tuskleric/AI_Robotic_Camera/PCB/FYP_P2_1/PCB_CONN_example_FYP.png

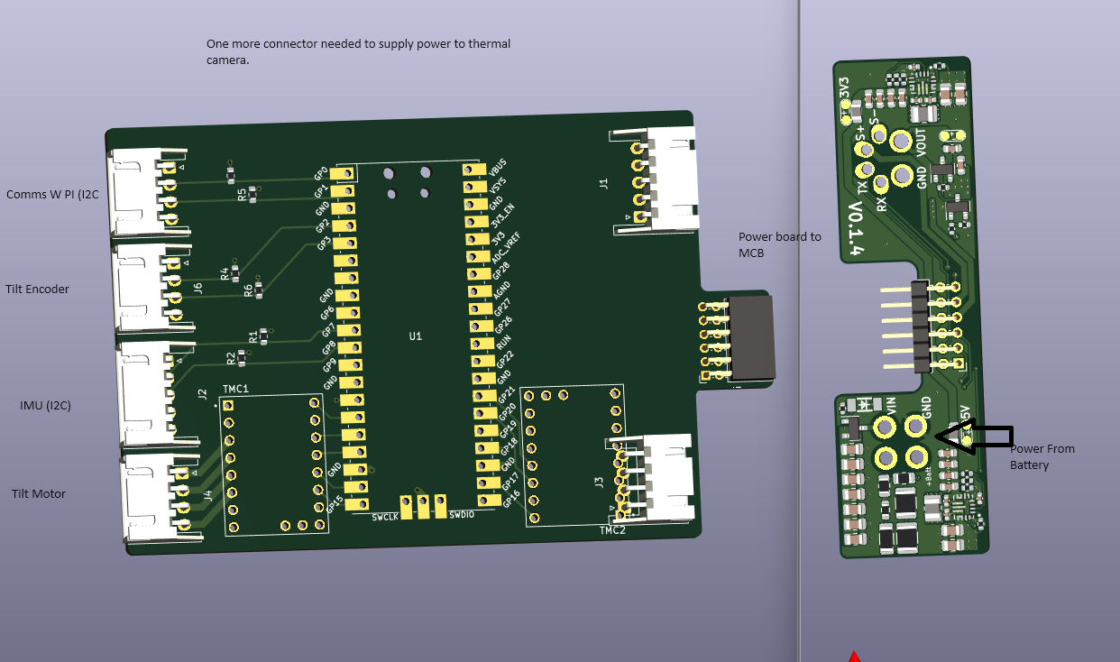
PCB/FYP_P2_1/PCB_CONN_example_FYP.png
