tuskleric/AI_Robotic_Camera/PCB/FYP_P2_2/out/FYP_P2_2_3D.png

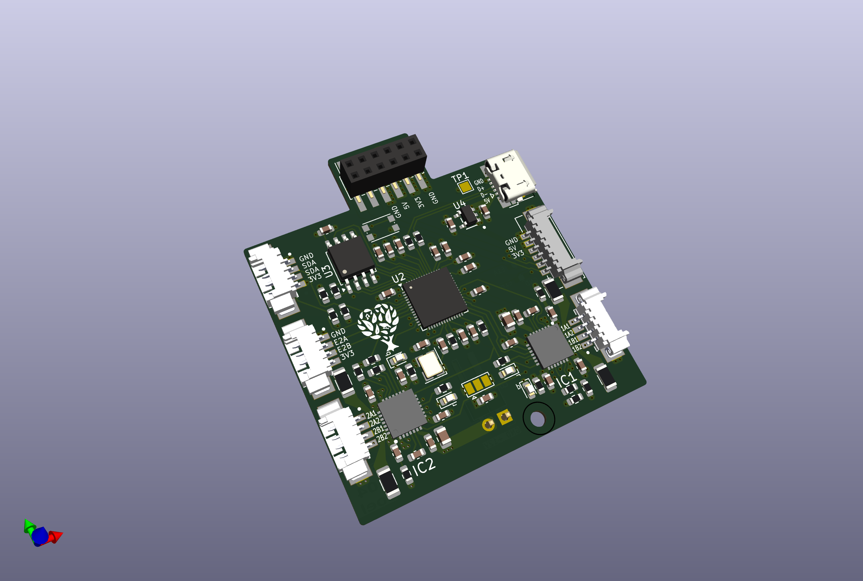
PCB/FYP_P2_2/out/FYP_P2_2_3D.png
