tuskleric/AI_Robotic_Camera/PCB/FYP_P2_2/out/FYP_P2_1.png

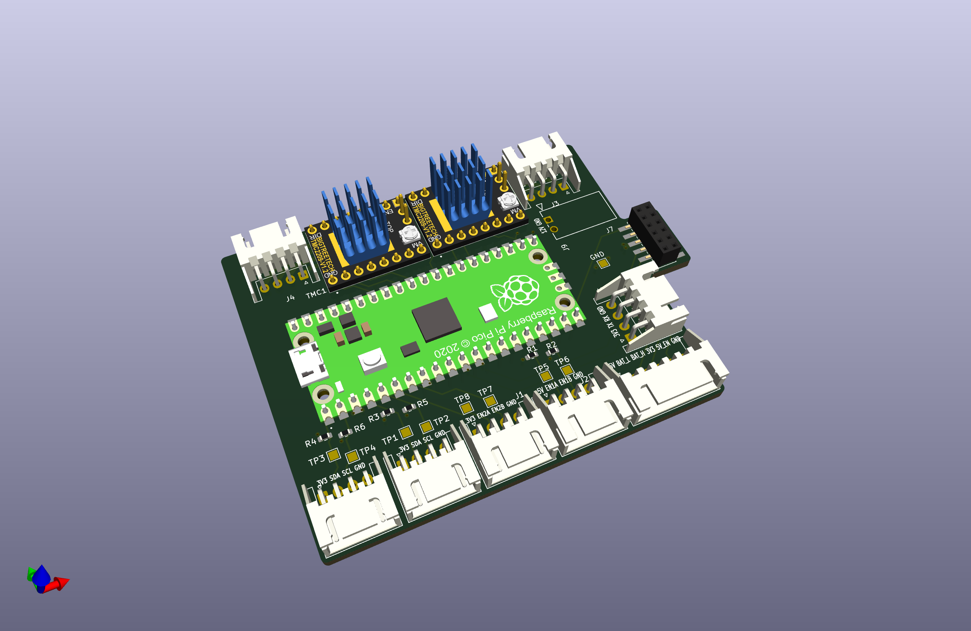
PCB/FYP_P2_2/out/FYP_P2_1.png
