tuskleric/AI_Robotic_Camera/PCB/FYP_P2_2/out/FYP_P2_2_3D_floating.png

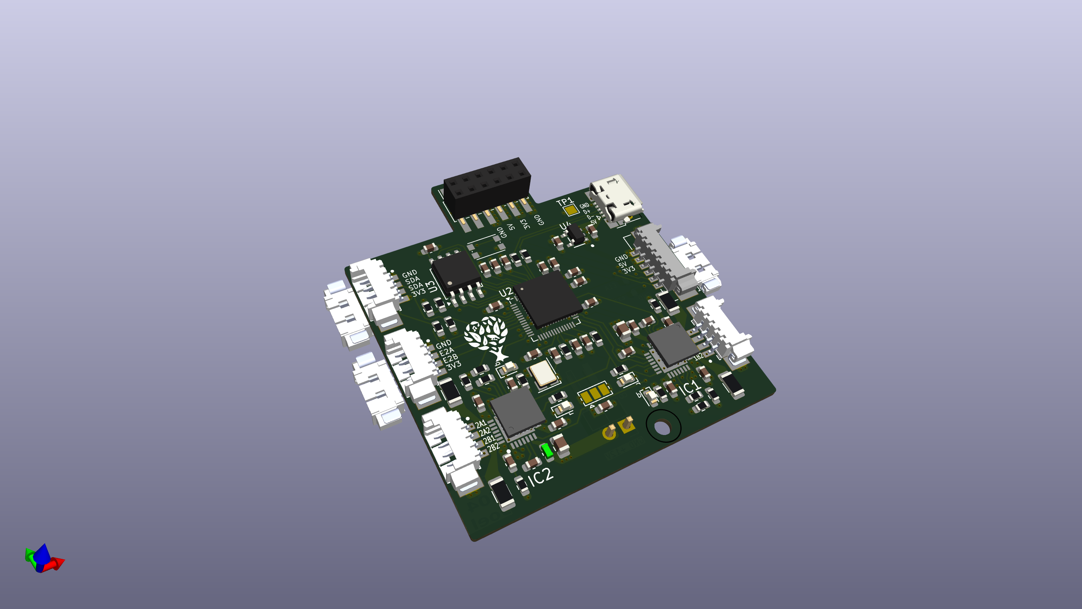
PCB/FYP_P2_2/out/FYP_P2_2_3D_floating.png
