tuskleric/AI_Robotic_Camera/PCB/FYP_P2_2/out/tc2-main-pcb.png

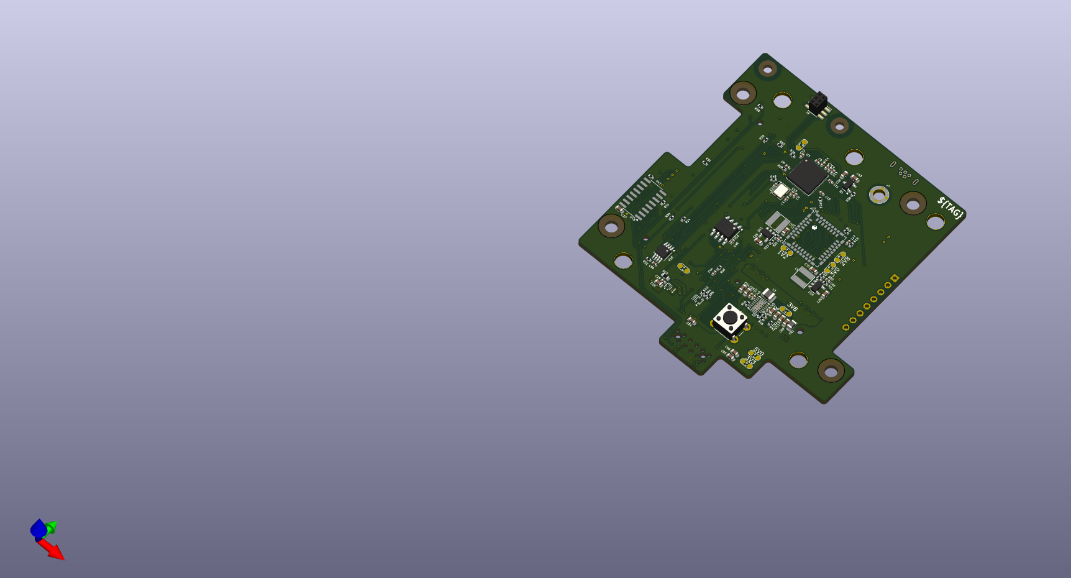
PCB/FYP_P2_2/out/tc2-main-pcb.png
