tuskleric/AI_Robotic_Camera/PCB/FYP_P2_2/out/tc2-plugs-buck-boost-pcb.png

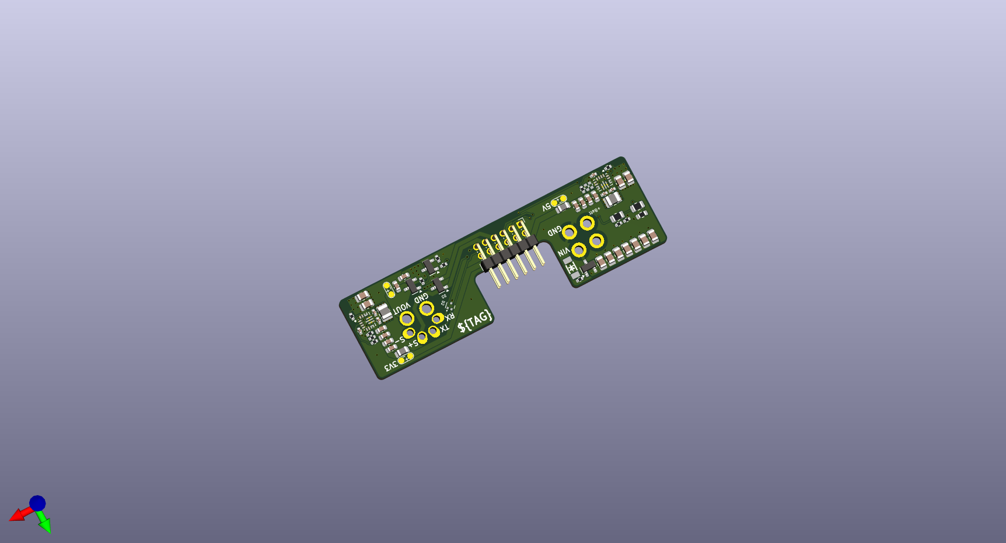
PCB/FYP_P2_2/out/tc2-plugs-buck-boost-pcb.png
