tuskleric/AI_Robotic_Camera/PCB/FYP_P2_2/out/FYP_P2_2_order_list.xlsx

Country of Origin may be different at time of shipment.
The HTSUS and ECCN information shown is for informational purposes only and is not a representation or warranty as to the accuracy or reliability of these classifications. All information is provided "as is" and is subject to change without notice. Any use made of the information provided is without recourse to Digi-Key and at the user's risk.
Index | Manufacturer Part Number | Manufacturer Name | Description | Availability | Stock Status | Attrition % | Requested Quantity 1 | Pack Quantity 1 | Pack Type 1 | Digi-Key Part Number 1 | Unit Price 1 | Extended Price 1 | Minimum Order Quantity 1 | Customer Reference | Requested Part Number | Lead Weeks | Datasheet | Reference Designator | US Import Tariff | Note | Part Status | RoHS Status | Moisture Sensitivity Level (MSL) | ECCN | HTSUS | Country of Origin | Environmental Information | Original Part numbers | Image | Product Notes
1 | 0532610471 | Molex | CONN HEADER SMD R/A 4POS 1.25MM | 68,219 | In Stock |  | 20 | 20 | Cut Tape (CT) | WM7622CT-ND | 0.61200 | $12.24 | 1 |  | WM7622CT-ND | 21 | https://www.molex.com/pdm_docs/sd/532610471_sd.pdf |  | N/A |  | Active | ROHS3 Compliant | 1 (Unlimited) | EAR99 | 8536.69.4040 | Malaysia | https://www.molex.com/datasheets/rohspdf/0532610471_rohs.pdf | WM7622CT-ND | https://mm.digikey.com/Volume0/opasdata/d220001/medias/images/1277/0532610471.jpg
2 | 0532610671 | Molex | CONN HEADER SMD R/A 6POS 1.25MM | 32,107 | In Stock |  | 5 | 5 | Cut Tape (CT) | WM7624CT-ND | 0.82000 | $4.10 | 1 |  | WM7624CT-ND | 22 | https://www.molex.com/pdm_docs/sd/532610671_sd.pdf |  | May apply on shipments to the U.S. |  | Active | ROHS3 Compliant | 1 (Unlimited) | EAR99 | 8536.69.4040 | Malaysia | https://www.molex.com/datasheets/rohspdf/0532610671_rohs.pdf | WM7624CT-ND | https://mm.digikey.com/Volume0/opasdata/d220001/medias/images/1138/53261-0671.jpg
3 | KMR211NG LFS | C&K | SWITCH TACTILE SPST-NO 0.05A 32V | 75,146 | In Stock |  | 5 | 5 | Cut Tape (CT) | CKN10243CT-ND | 0.40000 | $2.00 | 1 |  | CKN10243CT-ND | 8 | https://www.ckswitches.com/media/1479/kmr2.pdf |  | N/A |  | Active | ROHS3 Compliant | 1 (Unlimited) | EAR99 | 8536.50.9031 | France | https://www.ckswitches.com/media/3448/rohs-reach-compliance-certificate.pdf | CKN10243CT-ND | https://mm.digikey.com/Volume0/opasdata/d220001/medias/images/2588/KMR211NG%20LFS.JPG
4 | 0510210400 | Molex | CONN RCPT HSG 4POS 1.25MM | 92,947 | In Stock |  | 20 | 20 | Bag | WM1722-ND | 0.19800 | $3.96 | 1 |  | WM1722-ND | 9 | https://www.molex.com/pdm_docs/ps/PS-51021-009.pdf |  | N/A |  | Active | ROHS3 Compliant | 1 (Unlimited) | EAR99 | 8536.69.8000 | South Korea | https://www.molex.com/datasheets/rohspdf/0510210400_rohs.pdf | WM1722-ND | https://mm.digikey.com/Volume0/opasdata/d220001/medias/images/906/51021-0400.jpg
5 | 0500798000 | Molex | CONN SOCKET 26-28AWG CRIMP TIN | 444,262 | In Stock |  | 100 | 100 | Cut Tape (CT) | WM1142CT-ND | 0.04270 | $4.27 | 100 |  | WM1142CT-ND | 29 | https://www.molex.com/pdm_docs/cs/500580000-CS-000.pdf |  | N/A |  | Active | ROHS3 Compliant | 1 (Unlimited) | EAR99 | 8536.90.4000 | Malaysia | https://www.molex.com/datasheets/rohspdf/0500798000_rohs.pdf | WM1142CT-ND | https://mm.digikey.com/Volume0/opasdata/d220001/medias/images/1075/50079-8000.jpg
6 | 0510210600 | Molex | CONN RCPT HSG 6POS 1.25MM | 197,973 | In Stock |  | 5 | 5 | Bulk | WM1724-ND | 0.29000 | $1.45 | 1 |  | WM1724-ND | 8 | https://www.molex.com/pdm_docs/ps/PS-51021-009.pdf |  | N/A |  | Active | ROHS3 Compliant | 1 (Unlimited) | EAR99 | 8536.69.8000 | South Korea | https://www.molex.com/datasheets/rohspdf/0510210600_rohs.pdf | WM1724-ND | https://mm.digikey.com/Volume0/opasdata/d220001/medias/images/986/51021-0600.jpg
7 | GMC10X7R105K50NT | Cal-Chip Electronics, Inc. | CAP0603 X7R 1UF 10% 50V | 3,543 | In Stock |  | 10 | 10 | Cut Tape (CT) | 4713-GMC10X7R105K50NTCT-ND | 0.14400 | $1.44 | 1 |  | 4713-GMC10X7R105K50NTCT-ND | 8 | https://calchip.com/wp-content/uploads/2023/09/GMC-Series-2.pdf |  | N/A |  | Active | ROHS3 Compliant | 1 (Unlimited) | EAR99 | 8532.24.0020 | South Korea | https://88c.e57.myftpupload.com/wp-content/uploads/2022/06/Certificate-of-Compliance.pdf | 4713-GMC10X7R105K50NTCT-ND | https://mm.digikey.com/Volume0/opasdata/d220001/medias/images/4904/MFG_GMC43X5R226K10NT.jpg | Non Cancellable Non Returnable.
8 | KGM15CR51E226MT | KYOCERA AVX | 0603 X5R 22UF20% 25V | 0 | Normally Stocking |  | 5 | 5 | Cut Tape (CT) | 478-KGM15CR51E226MTCT-ND | 0.42000 | $2.10 | 1 |  | 478-KGM15CR51E226MTCT-ND | 16 | https://datasheets.kyocera-avx.com/cx5r-KGM.pdf |  | N/A |  | Active | ROHS3 Compliant | 1 (Unlimited) | EAR99 | 8532.24.0020 | Japan |  | 478-KGM15CR51E226MTCT-ND | https://mm.digikey.com/Volume0/opasdata/d220001/medias/images/6295/MFG_KGMSERIES.jpg
9 | GRM21BR61H106KE43K | Murata Electronics | CAP CER 10UF 50V X5R 0805 | 3 | In Stock |  | 10 | 10 | Cut Tape (CT) | 490-GRM21BR61H106KE43KCT-ND | 0.19100 | $1.91 | 1 |  | 490-GRM21BR61H106KE43KCT-ND | 19 | https://search.murata.co.jp/Ceramy/image/img/A01X/G101/ENG/GRM21BR61H106KE43-01A.pdf |  | N/A |  | Active | ROHS3 Compliant | 1 (Unlimited) | EAR99 | 8532.24.0020 | Japan |  | 490-GRM21BR61H106KE43KCT-ND | https://mm.digikey.com/Volume0/opasdata/d220001/medias/images/5447/490-Ceramic-Capacitor-Tan-Field.jpg
10 | TMC2209-LA | Analog Devices Inc./Maxim Integrated | IC MTR DRV 4.75-28V QFN28 | 421 | In Stock |  | 6 | 6 | Tray | 505-TMC2209-LA-ND | 2.47000 | $14.82 | 1 |  | 505-TMC2209-LA-ND | 18 | https://www.analog.com/media/en/technical-documentation/data-sheets/TMC2209_datasheet_rev1.09.pdf |  | N/A |  | Active | ROHS3 Compliant | 3 (168 Hours) | EAR99 | 8542.39.0060 | Taiwan | https://www.trinamic.com/fileadmin/assets/Company/Quality/TMC_IC_ROHS_3v6.pdf | 505-TMC2209-LA-ND
11 | SC0914(13) | Raspberry Pi | IC MCU 32BIT EXT MEM 56QFN | 47,248 | In Stock |  | 5 | 5 | Cut Tape (CT) | 2648-SC0914(13)CT-ND | 0.70000 | $3.50 | 1 |  | 2648-SC0914(13)CT-ND | 8 | https://datasheets.raspberrypi.com/rp2040/rp2040-datasheet.pdf |  | N/A |  | Active | ROHS3 Compliant | 1 (Unlimited) | 3A991A2 | 8542.31.0025 | Taiwan | https://pip.raspberrypi.com/categories/601-documents-covering-all-products | 2648-SC0914(13)CT-ND | https://mm.digikey.com/Volume0/opasdata/d220001/medias/images/4303/MFG_RP2040.jpg
12 | W25Q128JVSIQ | Winbond Electronics | IC FLASH 128MBIT SPI/QUAD 8SOIC | 91,047 | In Stock |  | 5 | 5 | Tube | W25Q128JVSIQ-ND | 1.73000 | $8.65 | 1 |  | W25Q128JVSIQ-ND | 12 | https://www.winbond.com/resource-files/W25Q128JV%20RevI%2008232021%20Plus.pdf |  | N/A |  | Active | ROHS3 Compliant | 3 (168 Hours) | 3A991B1A | 8542.32.0071 | Taiwan | https://www.winbond.com/hq/support/documentation/?pageIndex=1&__locale=en | W25Q128JVSIQ-ND | https://mm.digikey.com/Volume0/opasdata/d220001/medias/images/371/8-SOIC_751.jpg
13 | ABM8-272-T3 | Abracon LLC | CRYSTAL 12.0000MHZ 10PF SMD | 8,033 | In Stock |  | 5 | 5 | Cut Tape (CT) | 535-ABM8-272-T3CT-ND | 0.58000 | $2.90 | 1 |  | 535-ABM8-272-T3CT-ND | 15 | https://mm.digikey.com/Volume0/opasdata/d220001/medias/docus/6128/ABM8-272-T3.pdf |  | May apply on shipments to the U.S. |  | Active | ROHS3 Compliant | Not Applicable | EAR99 | 8541.60.0050 | China |  | 535-ABM8-272-T3CT-ND | https://mm.digikey.com/Volume0/opasdata/d220001/medias/images/4464/MFG_ABM8.jpg | No Backorders Allowed.
14 | BF100-12-A-D-1-0640-L-C | GCT | 12POS, 2MM PITCH SOCKET, DIL, SM | 2,367 | In Stock |  | 10 | 10 | Cut Tape (CT) | 2073-BF100-12-A-D-1-0640-L-CCT-ND | 0.46800 | $4.68 | 1 |  | 2073-BF100-12-A-D-1-0640-L-CCT-ND | 9 | https://gct.co/files/drawings/bf100.pdf |  | May apply on shipments to the U.S. |  | Active | ROHS3 Compliant | 1 (Unlimited) | EAR99 | 8536.69.4040 | China | https://gct.co/files/info/gct_certificate_of_compliance.pdf | 2073-BF100-12-A-D-1-0640-L-CCT-ND | https://mm.digikey.com/Volume0/opasdata/d220001/medias/images/4280/MFG_BF100-12-A-x-x-06xx-x-x.jpg
15 | 2N7002NXAKR | Nexperia USA Inc. | MOSFET N-CH 60V 190MA TO236AB | 69,351 | In Stock |  | 10 | 10 | Cut Tape (CT) | 1727-8643-1-ND | 0.10500 | $1.05 | 1 |  | 1727-8643-1-ND | 6 | https://assets.nexperia.com/documents/data-sheet/2N7002NXAK.pdf |  | N/A |  | Active | ROHS3 Compliant | 1 (Unlimited) | EAR99 | 8541.29.0095 | Malaysia |  | 1727-8643-1-ND | https://mm.digikey.com/Volume0/opasdata/d220001/medias/images/5527/1727%7ESOT23-3%7ES23%7E3.jpg
16 | CRL1206-FW-R150ELF | Bourns Inc. | RES 0.15 OHM 1% 1/2W 1206 | 24,764 | In Stock |  | 10 | 10 | Cut Tape (CT) | 118-CRL1206-FW-R150ELFCT-ND | 0.10800 | $1.08 | 1 |  | 118-CRL1206-FW-R150ELFCT-ND | 14 | https://www.bourns.com/docs/Product-Datasheets/CRL.pdf |  | N/A |  | Active | ROHS3 Compliant | 1 (Unlimited) | EAR99 | 8533.21.0030 | Taiwan | https://www.bourns.com/docs/Product-MDS/crl1206_mds.pdf|https://www.bourns.com/docs/rohs-content/bourns-reach-letter.pdf|https://www.bourns.com/docs/rohs-cofc/crx_coc2.pdf?sfvrsn=da0774f6_12 | 118-CRL1206-FW-R150ELFCT-ND | https://mm.digikey.com/Volume0/opasdata/d220001/medias/images/2376/CRL%20Series%201206%20%283216%20Metric%29.jpg
