tuskleric/AI_Robotic_Camera/FYP_P2/BOM.xlsx

12 MHz crystal | 406C35D12M00000 | 406C35D12M00000 CTS-Frequency Controls | Crystals, Oscillators, Resonators | DigiKey (https://www.digikey.co.nz/en/products/detail/406C35D12M00000/CTX855CT-ND/2293035?curr=usd)
Flash memory | W25Q128JVS | https://www.digikey.co.nz/en/products/detail/winbond-electronics/W25Q128JVSIQ/5803943
