tuskleric/AI_Robotic_Camera/components_models/B4B-PH-SM4-TB/B4B-PH-SM4-TB.STEP

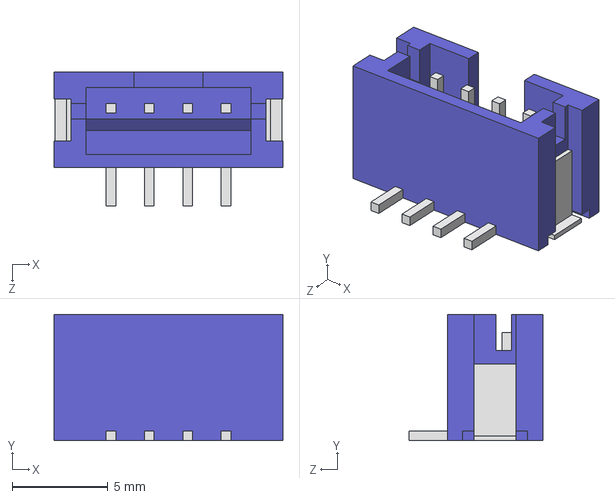
[picture p7: CAD file, 2024-05-13]
components_models/B4B-PH-SM4-TB/B4B-PH-SM4-TB.STEP
12.0 x 6.60 x 7.00 mm
