tuskleric/AI_Robotic_Camera/components_models/B5B-PH-SM4-TB/B5B-PH-SM4-TB.STEP

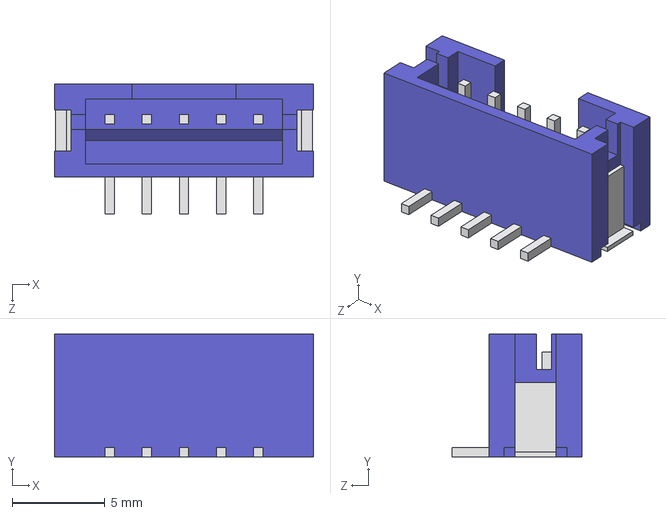
[picture p8: CAD file, 2024-05-13]
components_models/B5B-PH-SM4-TB/B5B-PH-SM4-TB.STEP
14.0 x 6.60 x 7.00 mm
