tuskleric/AI_Robotic_Camera/components_models/BOARD-BOARD/06JQ-ST/06JQ-ST.STEP

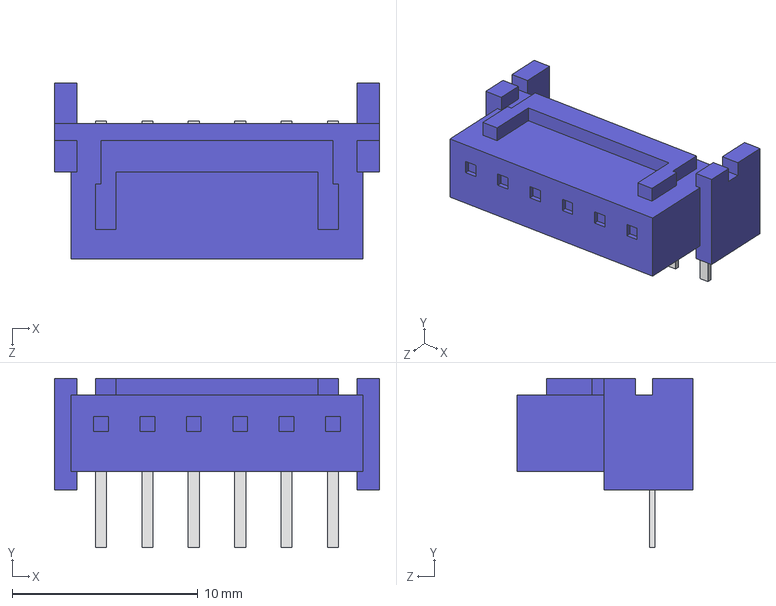
[picture p9: CAD file, 2024-05-13]
components_models/BOARD-BOARD/06JQ-ST/06JQ-ST.STEP
17.5 x 9.10 x 9.50 mm
