tuskleric/AI_Robotic_Camera/components_models/BOARD-BOARD/S5B-XH-A-1/S5B-XH-A-1.STEP

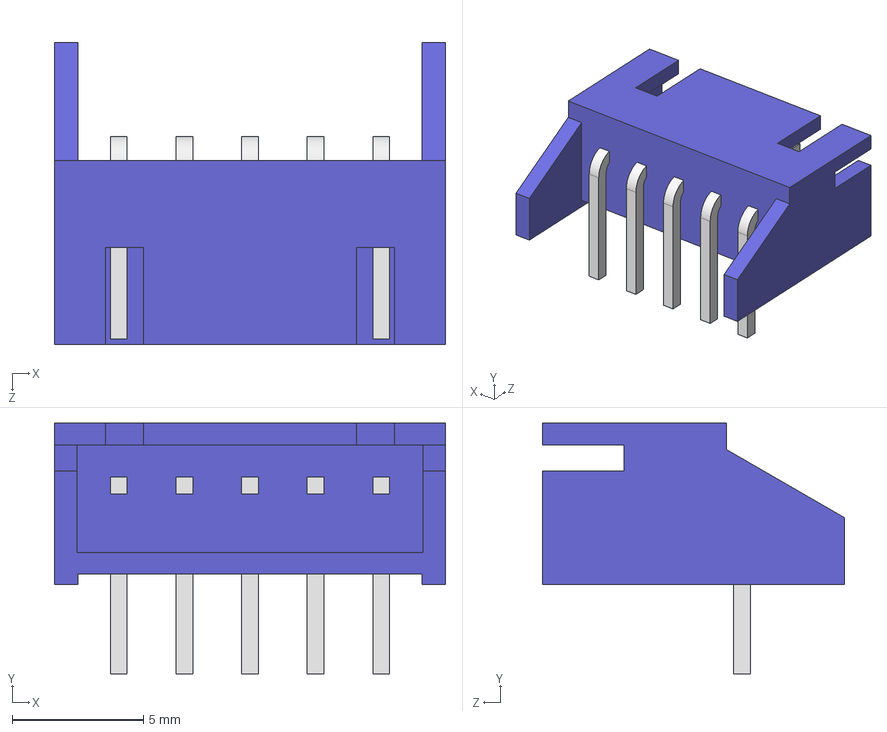
[picture p10: CAD file, 2024-05-13]
components_models/BOARD-BOARD/S5B-XH-A-1/S5B-XH-A-1.STEP
14.9 x 9.55 x 11.5 mm
