tuskleric/AI_Robotic_Camera/PCB/FYP_P2_1/raspberry pi pico with contacts.step

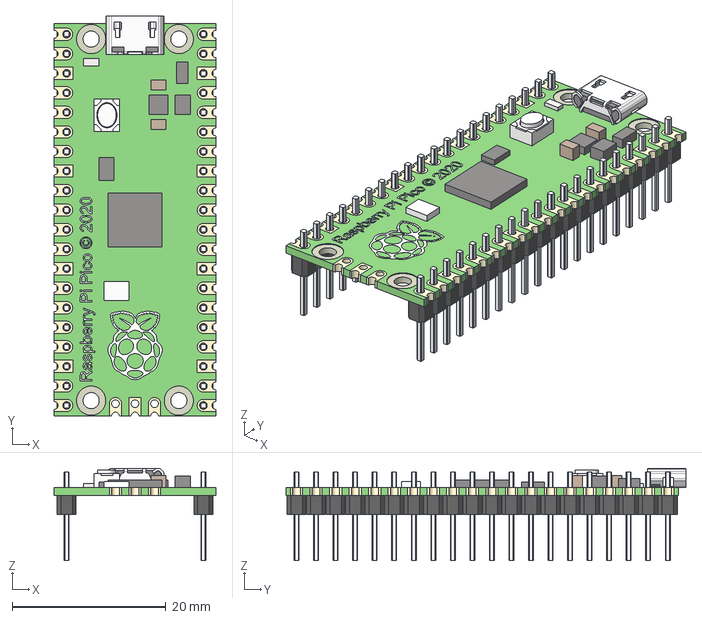
[picture p11: CAD file, 2024-10-09]
PCB/FYP_P2_1/raspberry pi pico with contacts.step
21.0 x 52.0 x 12.0 mm
ножка x 20
ножка v3(Mirror) x 20
