tuskleric/AI_Robotic_Camera/PCB/FYP_P2_2/components/LIB_TMC2209-LA/TMC2209-LA/3D/TMC2209-LA.stp

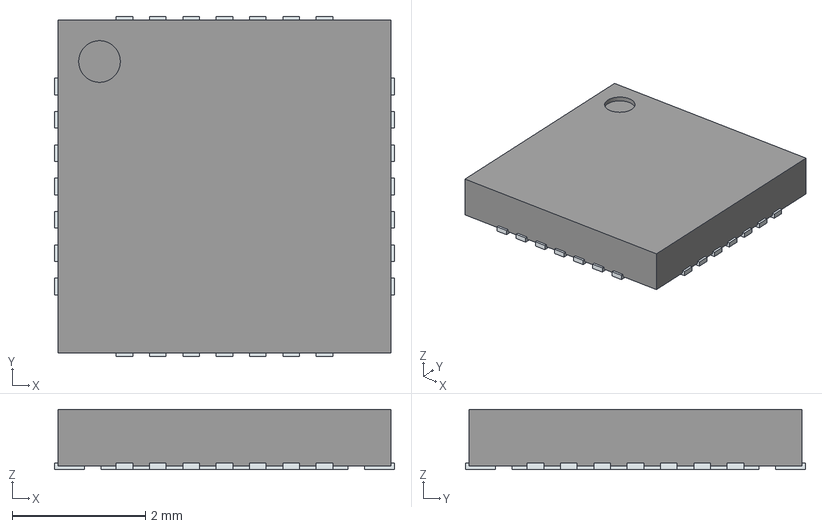
[picture p12: CAD file, 2024-10-09]
PCB/FYP_P2_2/components/LIB_TMC2209-LA/TMC2209-LA/3D/TMC2209-LA.stp
5.10 x 5.10 x 0.9 mm
ThermalPin
PinsArrayLR
PinsArrayTB
