tuskleric/AI_Robotic_Camera/PCB/FYP_P2_1/BTT TMC2209-V1.2.STEP

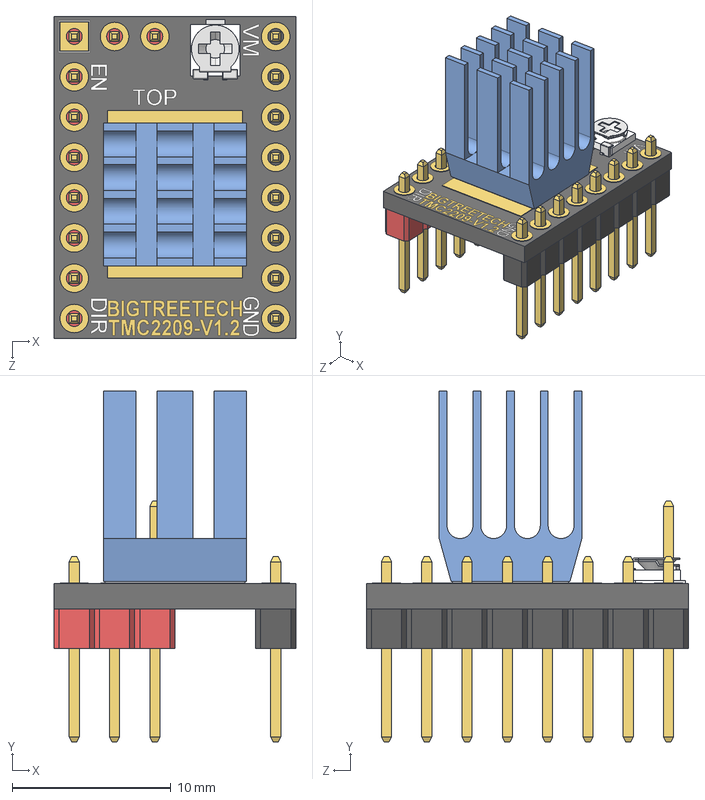
[picture p13: CAD file, 2024-10-09]
PCB/FYP_P2_1/BTT TMC2209-V1.2.STEP
15.2 x 22.1 x 20.3 mm
TMC2209_board
Pin_Header_1x2_red
Pin_Header_1x8_red
Pin_Header_1x8_black
EVM-3E___ _________
TMC2209_heatsink
