tuskleric/AI_Robotic_Camera/PCB/FYP_P2_1/pcb_19_07.step

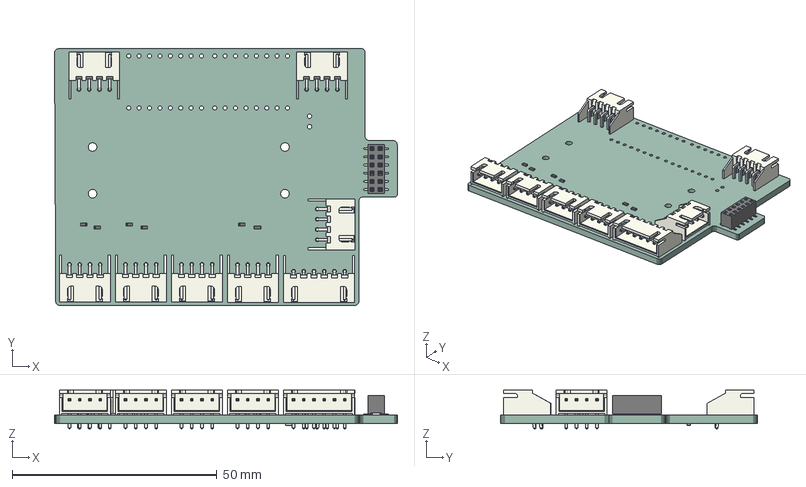
[picture p14: CAD file, 2024-10-09]
PCB/FYP_P2_1/pcb_19_07.step
83.8 x 62.8 x 9.50 mm
JST_S4B_XH_A x 7
R_0603_1608Metric x 7
PinSocket_2x06_P200mm_Vertical_SMD
JST_S6B_XH_A_1
FYP_P2_1 PCB
