tuskleric/AI_Robotic_Camera/PCB/FYP_P2_1/FYP_P2_1.step

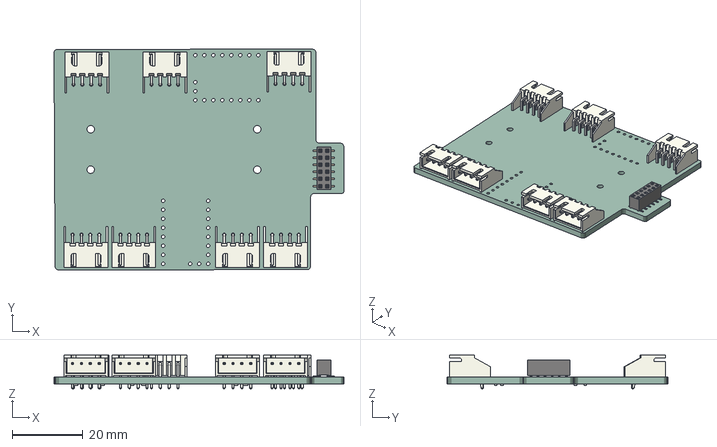
[picture p15: CAD file, 2024-10-09]
PCB/FYP_P2_1/FYP_P2_1.step
81.8 x 62.2 x 9.50 mm
PCB
