tuskleric/AI_Robotic_Camera/PCB/components_models/molex connector/1719740002(1)/1719740002.step

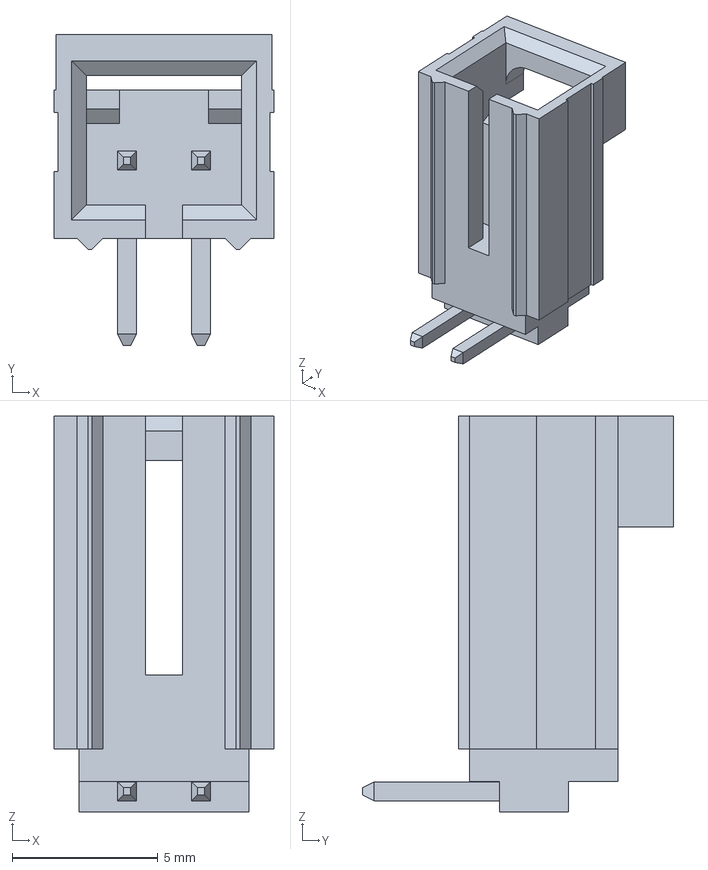
[picture p16: CAD file, 2024-10-09]
PCB/components_models/molex connector/1719740002(1)/1719740002.step
7.54 x 10.7 x 13.6 mm
