tuskleric/AI_Robotic_Camera/PCB/FYP_P2_2/components/0532610471/0532610471.step

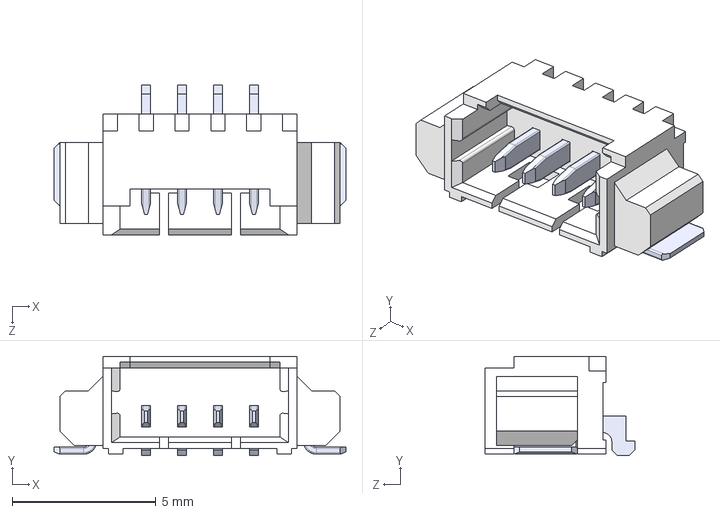
[picture p17: CAD file, 2024-10-09]
PCB/FYP_P2_2/components/0532610471/0532610471.step
10.2 x 3.45 x 5.20 mm
