tuskleric/AI_Robotic_Camera/PCB/FYP_P2_2/components/0532610671/532610671.step

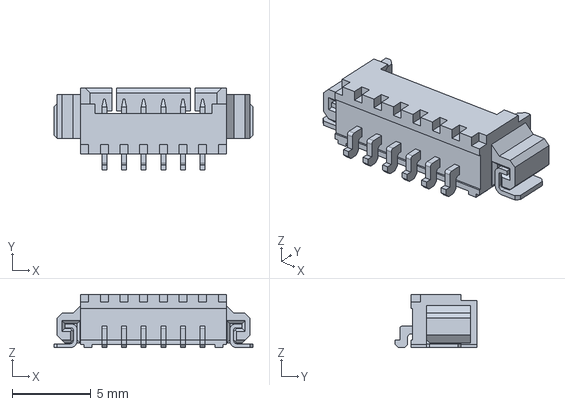
[picture p18: CAD file, 2024-10-09]
PCB/FYP_P2_2/components/0532610671/532610671.step
12.7 x 5.20 x 3.40 mm
