tuskleric/AI_Robotic_Camera/(list of files, cad)

Other CAD files:
PCB/FYP_P2_2/tc2-main.pcb.FCStd
PCB/FYP_P2_1/pcb_19_07.SLDPRT
PCB/FYP_P2_2/components/LIB_TMC2209-LA/TMC2209-LA/Allegro/qfn50p500x500x90-29n.psm
PCB/FYP_P2_2/components/LIB_TMC2209-LA/TMC2209-LA/DEHDL/tmc2209_la/chips/chips.prt
PCB/components_models/LIB_PICO/PICO/Allegro/pico.psm
PCB/components_models/LIB_PICO/PICO/DEHDL/pico/chips/chips.prt
