tuskleric/AI_Robotic_Camera/PCB/FYP_P2_2/out/F.pdf

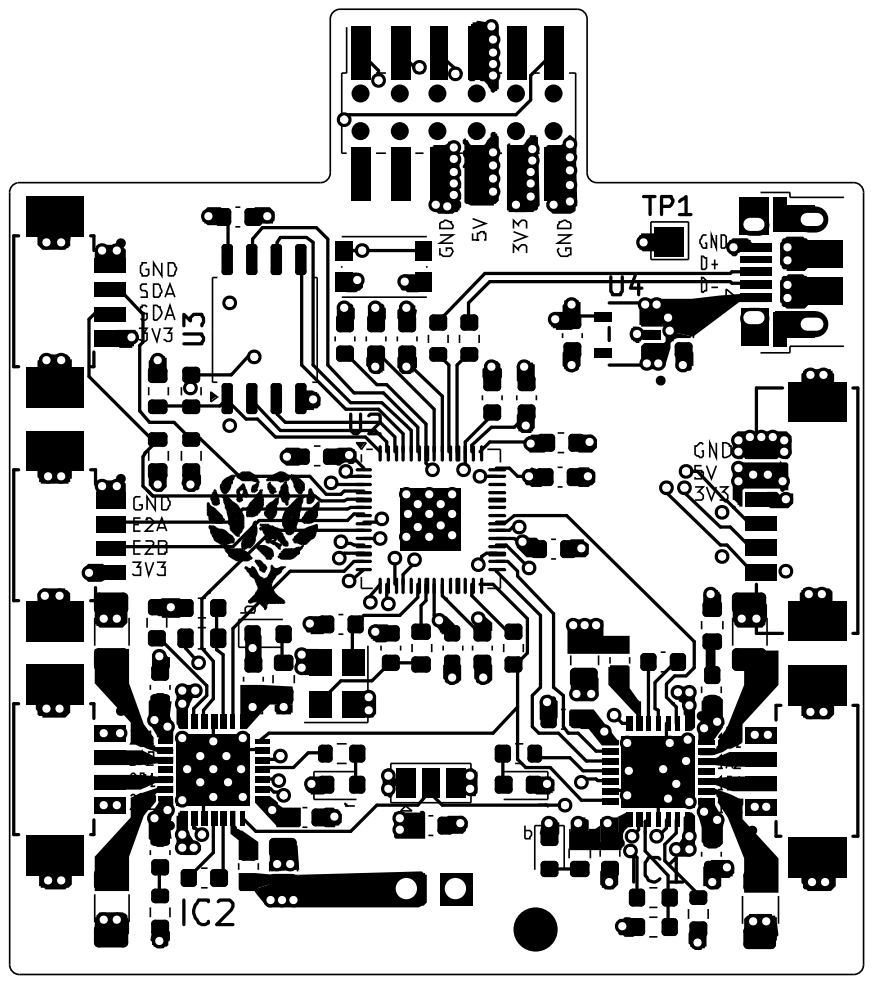
[picture p19: page 1]
