tuskleric/AI_Robotic_Camera/(list of files, drawings)

Other design files:
PCB/FYP_P2_2/components/LIB_TMC2209-LA/TMC2209-LA/Altium/QFN50P500X500X90-29N.PcbLib
PCB/FYP_P2_2/components/LIB_TMC2209-LA/TMC2209-LA/Altium/TMC2209-LA.SchLib
