tuskleric/AI_Robotic_Camera/PCB/FYP_P2_2/FYP_P2_2.kicad_pcb

## KiCad design PCB/FYP_P2_2/FYP_P2_2.kicad_pcb (2024-10-09)

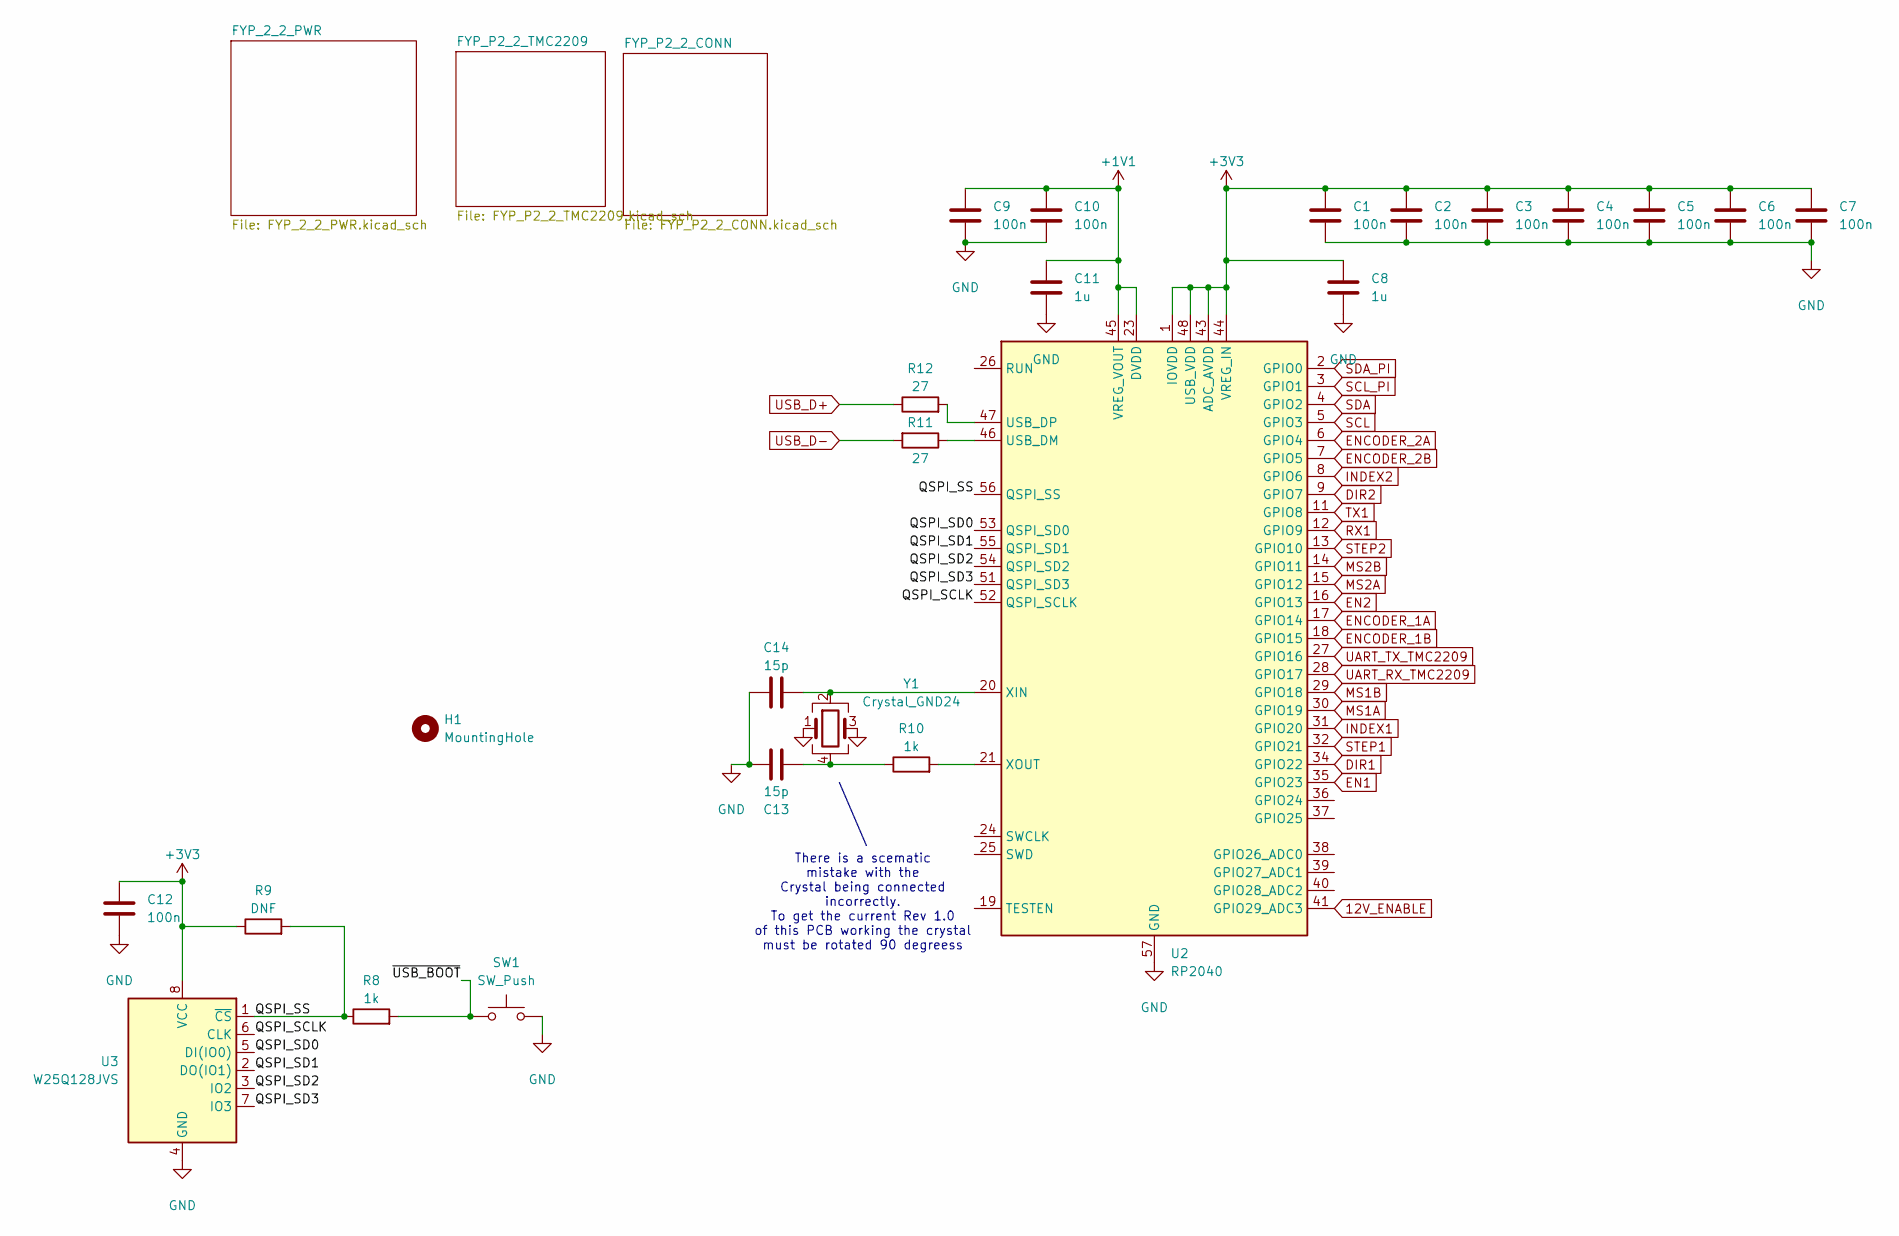
[picture p20: schematic FYP_P2_2.kicad_sch]

Parts:
C1, C2, C3, C4, C5, C6, C7, C9, C10, C12: 100n; C_0603_1608Metric
C8, C11: 1u; C_0603_1608Metric
C13, C14: 15p; C_0603_1608Metric
H1: MountingHole; MountingHole_2.2mm_M2
R8, R10: 1k; R_0603_1608Metric
R9: DNF; R_0603_1608Metric
R11, R12: 27; R_0603_1608Metric
SW1: SW_Push; SW_Push_1P1T_NO_CK_KMR2
U2: RP2040; QFN-56-1EP_7x7mm_P0.4mm_EP3.2x3.2mm
U3: W25Q128JVS; SOIC-8_5.23x5.23mm_P1.27mm
Y1: Crystal_GND24; Crystal_SMD_3225-4Pin_3.2x2.5mm

Connections:
12V_ENABLE: U2.41 (GPIO29_ADC3); also elsewhere on the board
+1V1: C9.1, C10.1, C11.1, U2.23 (DVDD), U2.45 (VREG_VOUT), U2.50 (DVDD)
+3V3: C1.1, C2.1, C3.1, C4.1, C5.1, C6.1, C7.1, C8.1, C12.1, R9.1, U2.1 (IOVDD), U2.10 (IOVDD), U2.22 (IOVDD), U2.33 (IOVDD), U2.42 (IOVDD), U2.43 (ADC_AVDD), U2.44 (VREG_IN), U2.48 (USB_VDD), U2.49 (IOVDD), U3.8 (VCC); also elsewhere on the board
/QSPI_SCLK: U2.52 (QSPI_SCLK), U3.6 (CLK)
/QSPI_SD0: U2.53 (QSPI_SD0), U3.5 (DI(IO0))
/QSPI_SD1: U2.55 (QSPI_SD1), U3.2 (DO(IO1))
/QSPI_SD2: U2.54 (QSPI_SD2), U3.3 (IO2)
/QSPI_SD3: U2.51 (QSPI_SD3), U3.7 (IO3)
/QSPI_SS: R8.1, R9.2, U2.56 (QSPI_SS), U3.1 (~CS)
/~USB_BOOT: R8.2, SW1.1
DIR1: U2.34 (GPIO22); also elsewhere on the board
DIR2: U2.9 (GPIO7); also elsewhere on the board
EN1: U2.35 (GPIO23); also elsewhere on the board
EN2: U2.16 (GPIO13); also elsewhere on the board
ENCODER_1A: U2.17 (GPIO14); also elsewhere on the board
ENCODER_1B: U2.18 (GPIO15); also elsewhere on the board
ENCODER_2A: U2.6 (GPIO4); also elsewhere on the board
ENCODER_2B: U2.7 (GPIO5); also elsewhere on the board
GND: C1.2, C2.2, C3.2, C4.2, C5.2, C6.2, C7.2, C8.2, C9.2, C10.2, C11.2, C12.2, C13.1, C14.2, SW1.2, U2.57 (GND), U3.4 (GND), Y1.1, Y1.3; also elsewhere on the board
INDEX1: U2.31 (GPIO20); also elsewhere on the board
INDEX2: U2.8 (GPIO6); also elsewhere on the board
MS1A: U2.30 (GPIO19); also elsewhere on the board
MS1B: U2.29 (GPIO18); also elsewhere on the board
MS2A: U2.15 (GPIO12); also elsewhere on the board
MS2B: U2.14 (GPIO11); also elsewhere on the board
unnamed: C13.2, R10.1, Y1.4
unnamed: R11.1, U2.46 (USB_DM)
unnamed: R12.2, U2.47 (USB_DP)
unnamed: C14.1, U2.20 (XIN), Y1.2
unnamed: R10.2, U2.21 (XOUT)
RX1: U2.12 (GPIO9); also elsewhere on the board
SCL: U2.5 (GPIO3); also elsewhere on the board
SCL_PI: U2.3 (GPIO1); also elsewhere on the board
SDA: U2.4 (GPIO2); also elsewhere on the board
SDA_PI: U2.2 (GPIO0); also elsewhere on the board
STEP1: U2.32 (GPIO21); also elsewhere on the board
STEP2: U2.13 (GPIO10); also elsewhere on the board
TX1: U2.11 (GPIO8); also elsewhere on the board
UART_RX_TMC2209: U2.28 (GPIO17); also elsewhere on the board
UART_TX_TMC2209: U2.27 (GPIO16); also elsewhere on the board
USB_D+: R12.1; also elsewhere on the board
USB_D-: R11.2; also elsewhere on the board

Notes on the sheet:
There is a scematic mistake with the Crystal being connected incorrectly. To get the current Rev 1.0 of this PCB working the crystal must be rotated 90 degreess

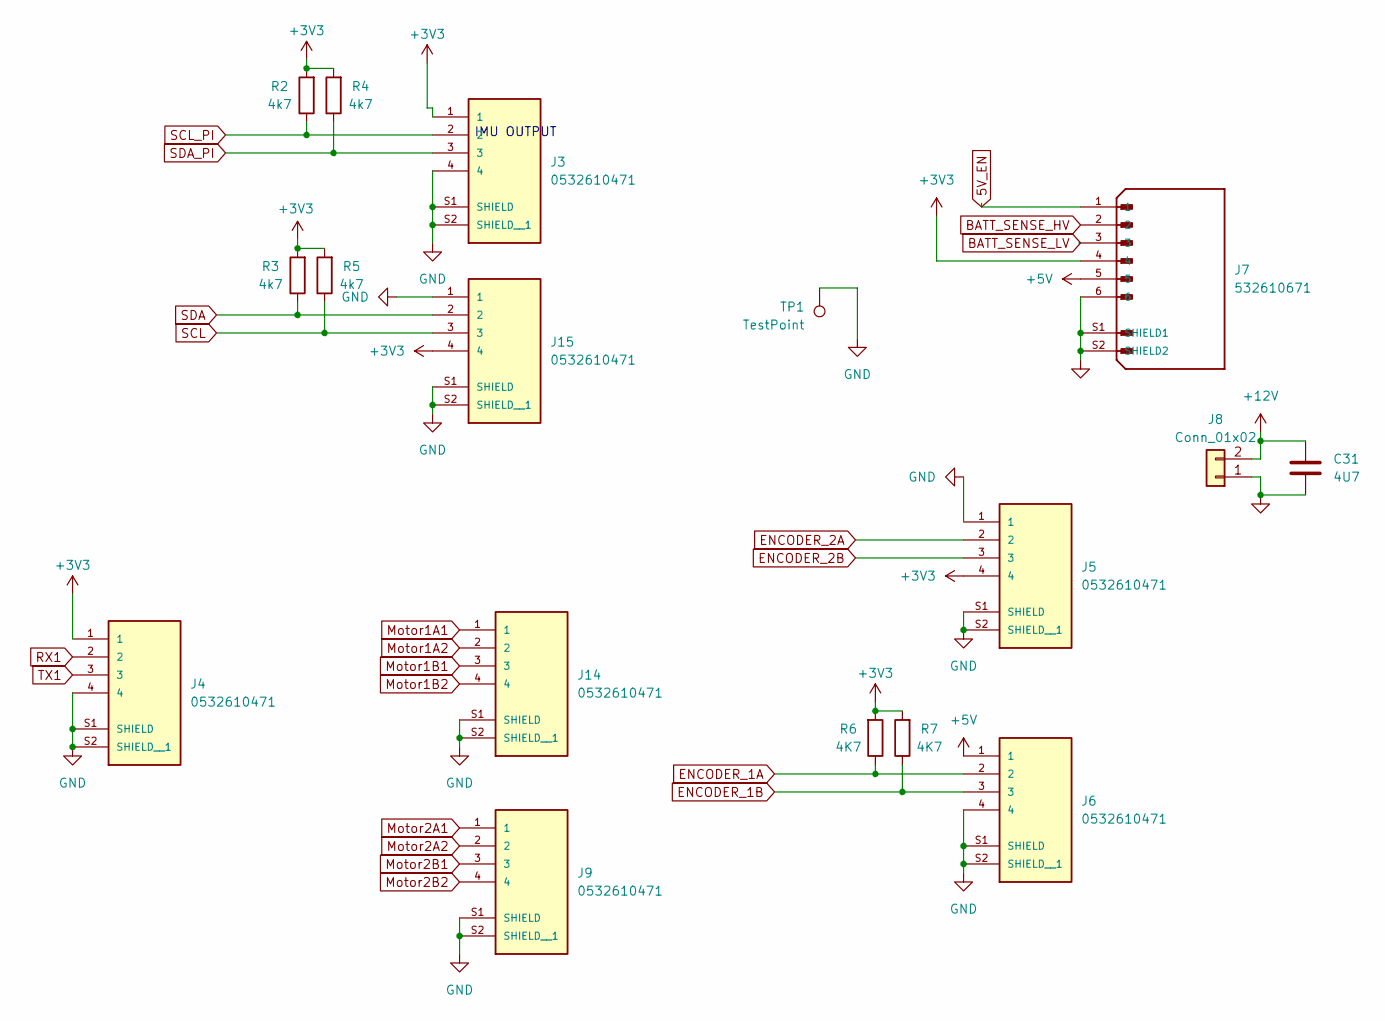
[picture p21: schematic FYP_P2_2_CONN.kicad_sch]

Parts:
C31: 4U7; C_0603_1608Metric
J3, J4, J5, J6, J9, J14, J15: 0532610471; MOLEX_0532610471; PARTREV J
J7: 532610671; MOLEX_532610671; PARTREV J
J8: Conn_01x02; PinHeader_1x02_P2.54mm_Horizontal
R2, R3, R4, R5: 4k7; R_0603_1608Metric
R6, R7: 4K7; R_0603_1608Metric
TP1: TestPoint; TestPoint_Pad_1.5x1.5mm

Connections:
5V_EN: J7.1; also elsewhere on the board
+3V3: J3.1, J4.1, J5.4, J7.4, J15.4, R2.2, R3.2, R4.2, R5.2, R6.2, R7.2; also elsewhere on the board
+5V: J6.1, J7.5; also elsewhere on the board
+12V: C31.1, J8.2; also elsewhere on the board
BATT_SENSE_HV: J7.2; also elsewhere on the board
BATT_SENSE_LV: J7.3; also elsewhere on the board
ENCODER_1A: J6.2, R6.1; also elsewhere on the board
ENCODER_1B: J6.3, R7.1; also elsewhere on the board
ENCODER_2A: J5.2; also elsewhere on the board
ENCODER_2B: J5.3; also elsewhere on the board
GND: C31.2, J3.4, J3.S1 (SHIELD), J3.S2 (SHIELD__1), J4.4, J4.S1 (SHIELD), J4.S2 (SHIELD__1), J5.1, J5.S1 (SHIELD), J5.S2 (SHIELD__1), J6.4, J6.S1 (SHIELD), J6.S2 (SHIELD__1), J7.6, J7.S1 (SHIELD1), J7.S2 (SHIELD2), J8.1, J9.S1 (SHIELD), J9.S2 (SHIELD__1), J14.S1 (SHIELD), J14.S2 (SHIELD__1), J15.1, J15.S1 (SHIELD), J15.S2 (SHIELD__1), TP1.1; also elsewhere on the board
Motor1A1: J14.1; also elsewhere on the board
Motor1A2: J14.2; also elsewhere on the board
Motor1B1: J14.3; also elsewhere on the board
Motor1B2: J14.4; also elsewhere on the board
Motor2A1: J9.1; also elsewhere on the board
Motor2A2: J9.2; also elsewhere on the board
Motor2B1: J9.3; also elsewhere on the board
Motor2B2: J9.4; also elsewhere on the board
RX1: J4.2; also elsewhere on the board
SCL: J15.3, R5.1; also elsewhere on the board
SCL_PI: J3.2, R2.1; also elsewhere on the board
SDA: J15.2, R3.1; also elsewhere on the board
SDA_PI: J3.3, R4.1; also elsewhere on the board
TX1: J4.3; also elsewhere on the board

Notes on the sheet:
IMU OUTPUT

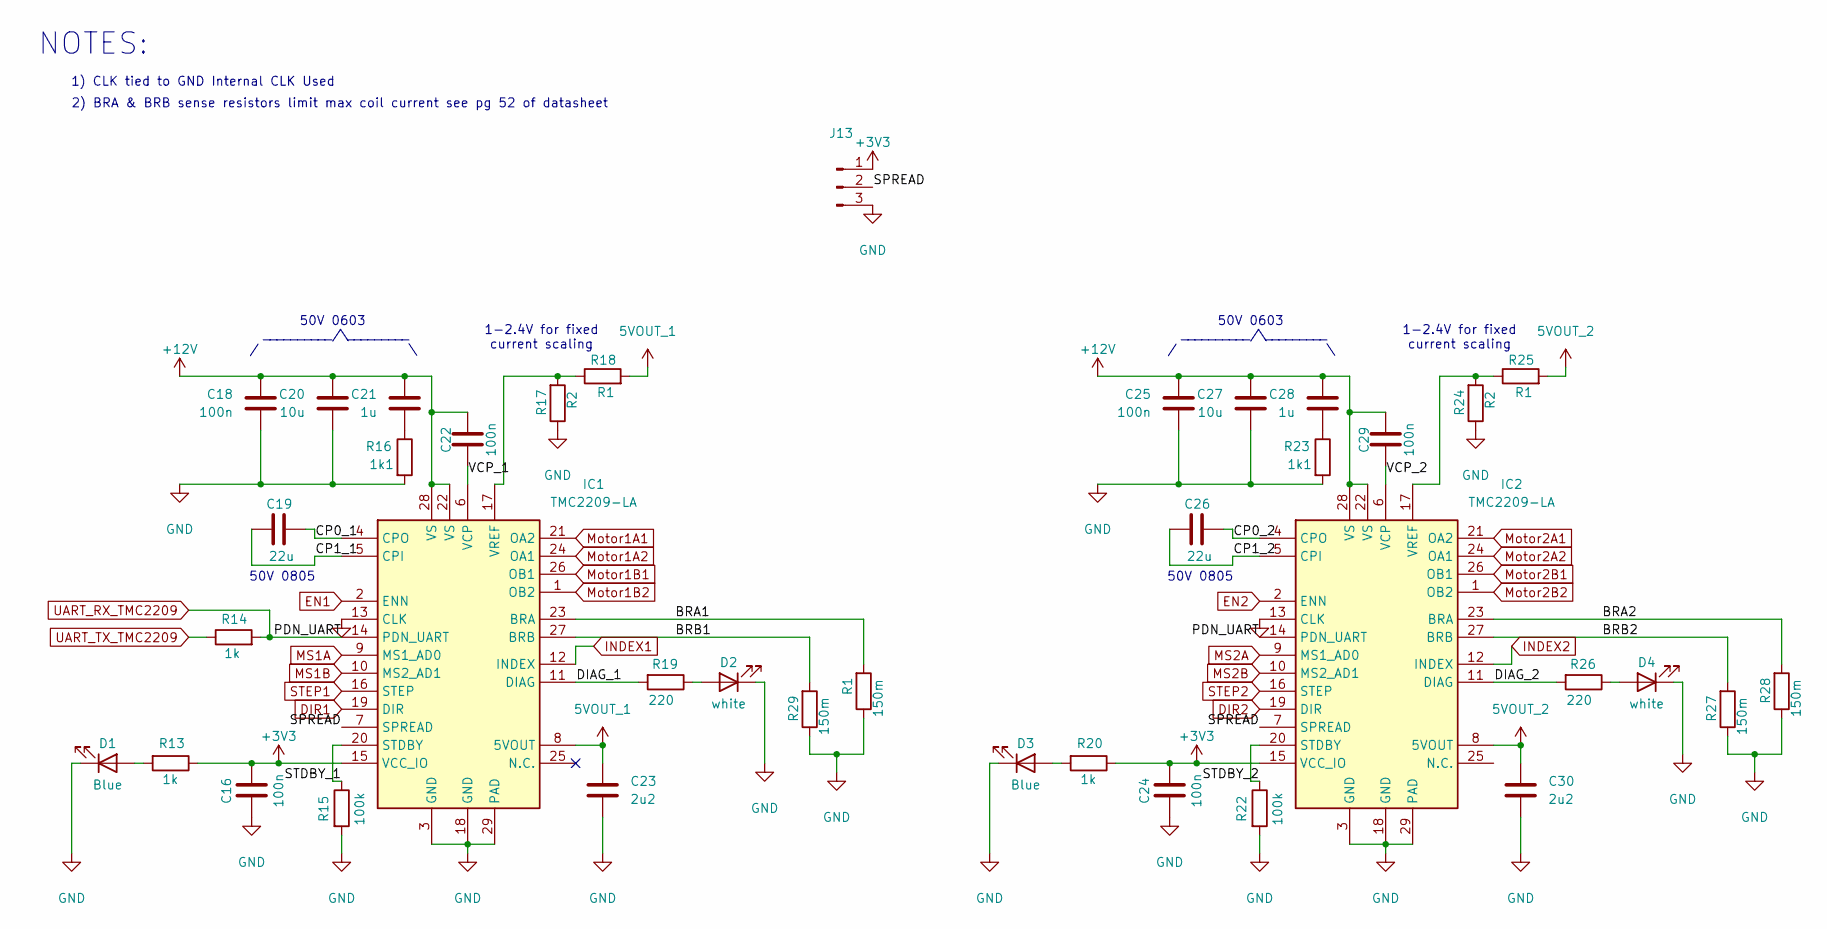
[picture p22: schematic FYP_P2_2_TMC2209.kicad_sch]

Parts:
C16, C18, C22, C24, C25, C29: 100n; C_0603_1608Metric
C19, C26: 22u; C_0603_1608Metric
C20, C27: 10u; C_0805_2012Metric
C21, C28: 1u; C_0603_1608Metric
C23, C30: 2u2; C_0603_1608Metric
D1, D3: Blue; LED_0603_1608Metric
D2, D4: white; LED_0603_1608Metric
IC1, IC2: TMC2209-LA; QFN50P500X500X90-29N; Manufacturer_Part_Number TMC2209-LA; Mouser Part Number 700-TMC2209-LA
J13: Conn_01x03_Pin; SolderJumper-3_P1.3mm_Open_Pad1.0x1.5mm
R1, R27, R28, R29: 150m; R_1206_3216Metric
R13, R14, R20: 1k; R_0603_1608Metric
R15, R22: 100k; R_0603_1608Metric
R16, R23: 1k1; R_0603_1608Metric
R17, R24: R2; R_0603_1608Metric
R18, R25: R1; R_0603_1608Metric
R19, R26: 220; R_0603_1608Metric

Connections:
5VOUT_1: C23.1, IC1.8 (5VOUT), R18.2
5VOUT_2: C30.1, IC2.8 (5VOUT), R25.2
+3V3: C16.1, C24.1, IC1.15 (VCC_IO), IC2.15 (VCC_IO), J13.1, R13.1, R20.1; also elsewhere on the board
+12V: C18.1, C20.1, C21.1, C22.1, C25.1, C27.1, C28.1, C29.1, IC1.22 (VS), IC1.28 (VS), IC2.22 (VS), IC2.28 (VS); also elsewhere on the board
/FYP_P2_2_TMC2209/BRA1: IC1.23 (BRA), R1.2
/FYP_P2_2_TMC2209/BRA2: IC2.23 (BRA), R28.2
/FYP_P2_2_TMC2209/BRB1: IC1.27 (BRB), R29.2
/FYP_P2_2_TMC2209/BRB2: IC2.27 (BRB), R27.2
/FYP_P2_2_TMC2209/CP0_1: C19.2, IC1.4 (CPO)
/FYP_P2_2_TMC2209/CP0_2: C26.2, IC2.4 (CPO)
/FYP_P2_2_TMC2209/CP1_1: C19.1, IC1.5 (CPI)
/FYP_P2_2_TMC2209/CP1_2: C26.1, IC2.5 (CPI)
/FYP_P2_2_TMC2209/DIAG_1: IC1.11 (DIAG), R19.2
/FYP_P2_2_TMC2209/DIAG_2: IC2.11 (DIAG), R26.2
/FYP_P2_2_TMC2209/SPREAD: IC1.7 (SPREAD), IC2.7 (SPREAD), J13.2
/FYP_P2_2_TMC2209/STDBY_1: IC1.20 (STDBY), R15.1
/FYP_P2_2_TMC2209/STDBY_2: IC2.20 (STDBY), R22.1
/FYP_P2_2_TMC2209/VCP_1: C22.2, IC1.6 (VCP)
/FYP_P2_2_TMC2209/VCP_2: C29.2, IC2.6 (VCP)
DIR1: IC1.19 (DIR); also elsewhere on the board
DIR2: IC2.19 (DIR); also elsewhere on the board
EN1: IC1.2 (ENN); also elsewhere on the board
EN2: IC2.2 (ENN); also elsewhere on the board
GND: C16.2, C18.2, C20.2, C23.2, C24.2, C25.2, C27.2, C30.2, D1.1 (K), D2.1 (K), D3.1 (K), D4.1 (K), IC1.3 (GND), IC1.13 (CLK), IC1.18 (GND), IC1.29 (PAD), IC2.3 (GND), IC2.13 (CLK), IC2.18 (GND), IC2.29 (PAD), J13.3, R1.1, R15.2, R16.2, R17.1, R22.2, R23.2, R24.1, R27.1, R28.1, R29.1; also elsewhere on the board
INDEX1: IC1.12 (INDEX); also elsewhere on the board
INDEX2: IC2.12 (INDEX); also elsewhere on the board
MS1A: IC1.9 (MS1_AD0); also elsewhere on the board
MS1B: IC1.10 (MS2_AD1); also elsewhere on the board
MS2A: IC2.9 (MS1_AD0); also elsewhere on the board
MS2B: IC2.10 (MS2_AD1); also elsewhere on the board
Motor1A1: IC1.21 (OA2); also elsewhere on the board
Motor1A2: IC1.24 (OA1); also elsewhere on the board
Motor1B1: IC1.26 (OB1); also elsewhere on the board
Motor1B2: IC1.1 (OB2); also elsewhere on the board
Motor2A1: IC2.21 (OA2); also elsewhere on the board
Motor2A2: IC2.24 (OA1); also elsewhere on the board
Motor2B1: IC2.26 (OB1); also elsewhere on the board
Motor2B2: IC2.1 (OB2); also elsewhere on the board
unnamed: C21.2, R16.1
unnamed: C28.2, R23.1
unnamed: D1.2 (A), R13.2
unnamed: D2.2 (A), R19.1
unnamed: D3.2 (A), R20.2
unnamed: D4.2 (A), R26.1
unnamed: IC1.17 (VREF), R17.2, R18.1
unnamed: IC2.17 (VREF), R24.2, R25.1
STEP1: IC1.16 (STEP); also elsewhere on the board
STEP2: IC2.16 (STEP); also elsewhere on the board
UART_RX_TMC2209: IC1.14 (PDN_UART), IC2.14 (PDN_UART), R14.2; also elsewhere on the board
UART_TX_TMC2209: R14.1; also elsewhere on the board

Notes on the sheet:
1-2.4V for fixed current scaling
2) BRA & BRB sense resistors limit max coil current see pg 52 of datasheet
50V 0603 __________/\_________ / \
50V 0805
NOTES:
1) CLK tied to GND Internal CLK Used

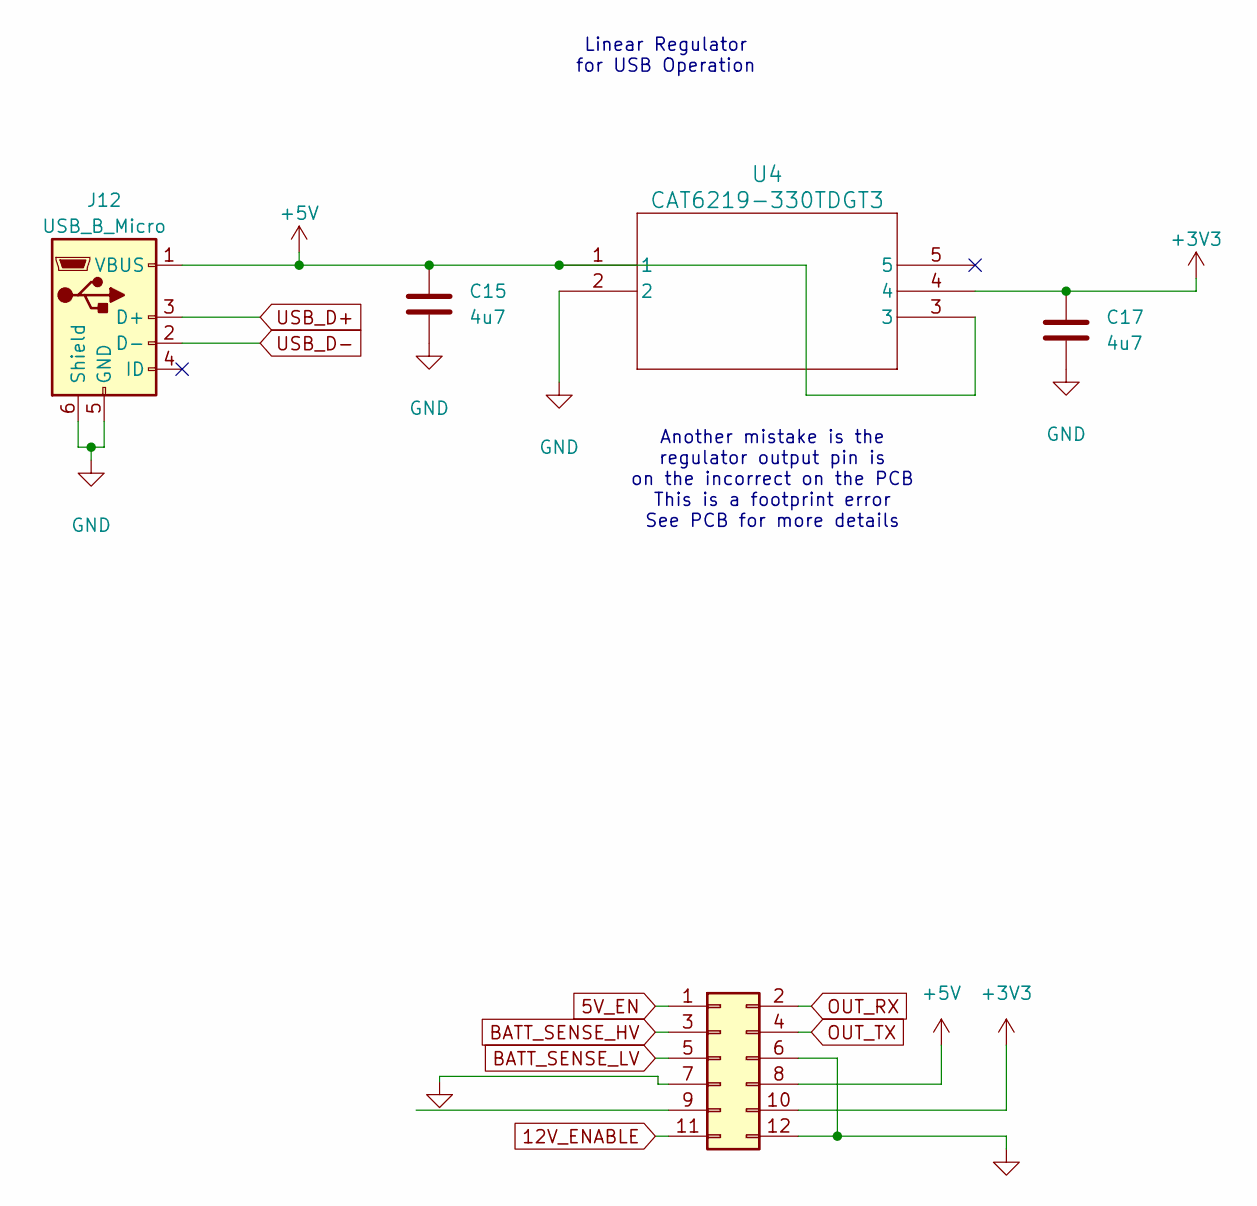
[picture p23: schematic FYP_2_2_PWR.kicad_sch]

Parts:
C15, C17: 4u7; C_0603_1608Metric
J2: Conn_02x06_Odd_Even; PinSocket_2x06_P2.00mm_Vertical_SMD; Digikey 2073-BF060-12A-B-0600-0280-0305-L-D-ND
J12: USB_B_Micro; USB_Micro-B_Amphenol_10103594-0001LF_Horizontal
U4: CAT6219-330TDGT3; TSOT23-5_ONS

Connections:
5V_EN: J2.1; also elsewhere on the board
12V_ENABLE: J2.11; also elsewhere on the board
+3V3: C17.1, J2.10, U4.4; also elsewhere on the board
+5V: C15.1, J2.8, J12.1 (VBUS), U4.1, U4.3; also elsewhere on the board
BATT_SENSE_HV: J2.3; also elsewhere on the board
BATT_SENSE_LV: J2.5; also elsewhere on the board
GND: C15.2, C17.2, J2.6, J2.7, J2.12, J12.5 (GND), J12.6 (Shield), U4.2; also elsewhere on the board
OUT_RX: J2.2
OUT_TX: J2.4
USB_D+: J12.3 (D+); also elsewhere on the board
USB_D-: J12.2 (D-); also elsewhere on the board

Notes on the sheet:
Another mistake is the regulator output pin is on the incorrect on the PCB This is a footprint error See PCB for more details
Linear Regulator for USB Operation

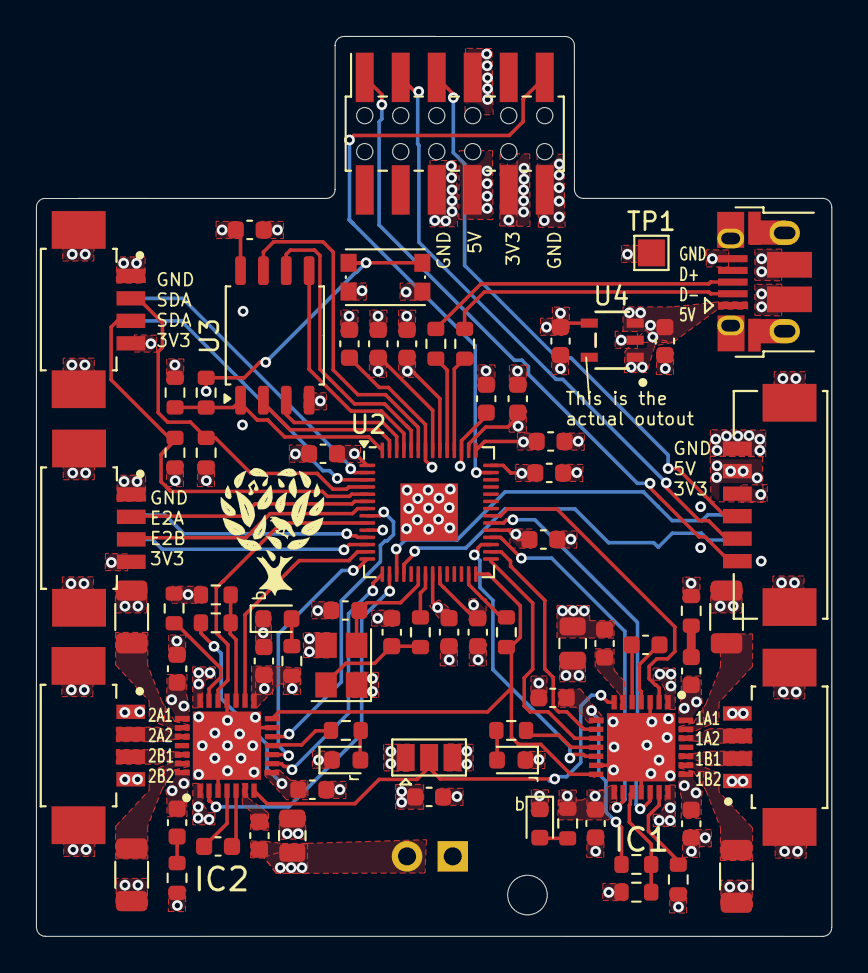
[picture p24: board FYP_P2_2.kicad_pcb from above]

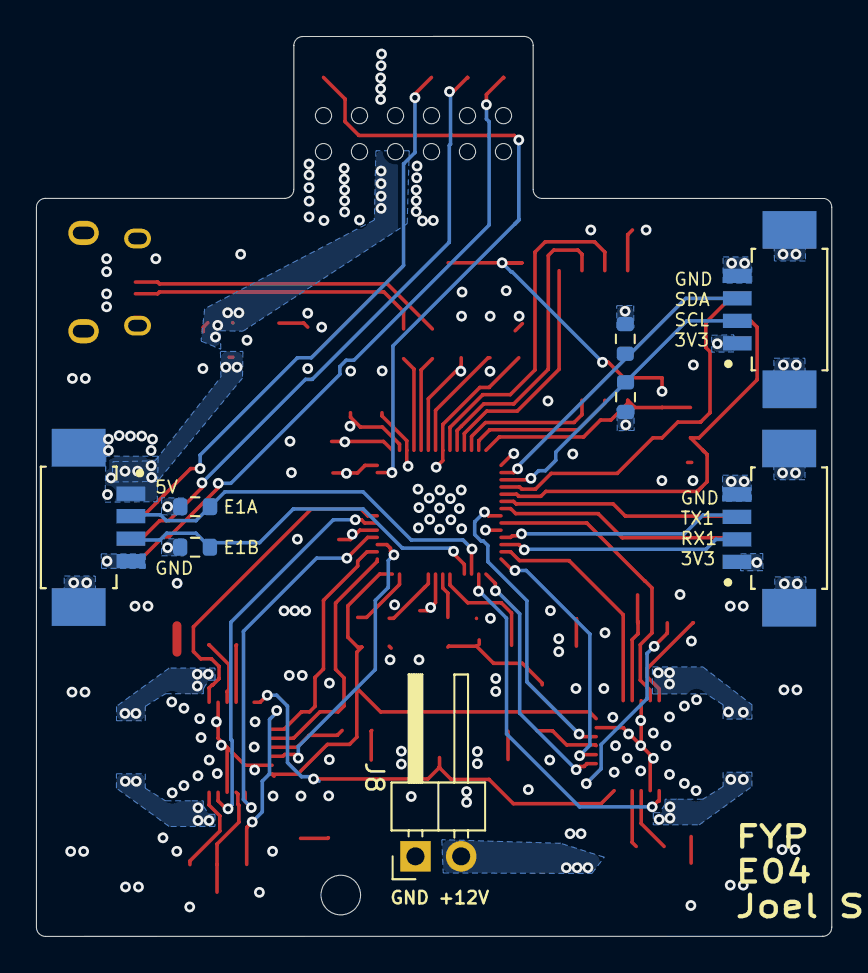
[picture p25: board FYP_P2_2.kicad_pcb from below]

Board: 4 copper layers, 44.2 x 50.0 mm, 84 parts (8 on the bottom side), 80 nets.
