tuskleric/AI_Robotic_Camera/PCB/FYP_P2_1/FYP_P2_1.kicad_pcb

## KiCad design PCB/FYP_P2_1/FYP_P2_1.kicad_pcb (2024-10-09)

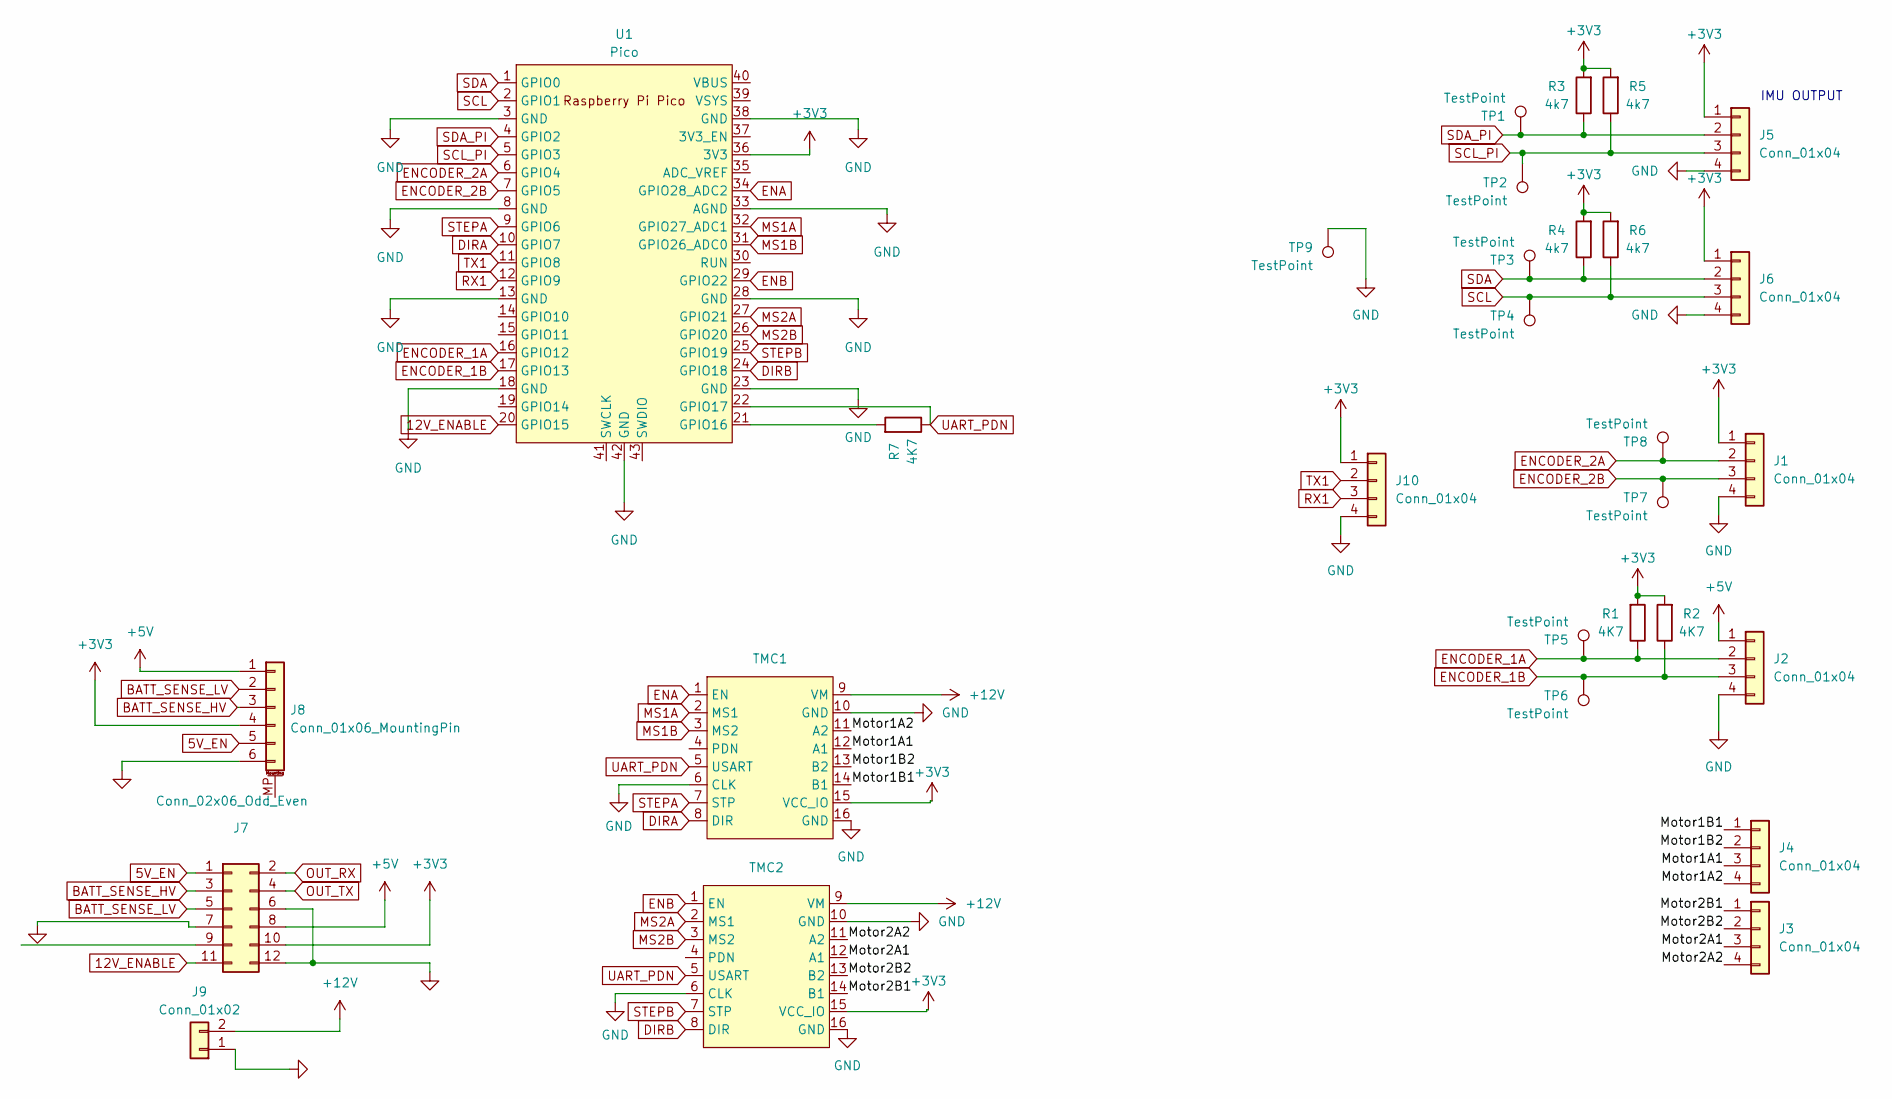
[picture p26: schematic FYP_P2_1.kicad_sch, Cacophony FYP E04 prototype 2]

Parts:
J1, J2, J3, J4, J5, J6, J10: Conn_01x04; JST_XH_S4B-XH-A_1x04_P2.50mm_Horizontal
J7: Conn_02x06_Odd_Even; PinSocket_2x06_P2.00mm_Vertical_SMD; Digikey 2073-BF060-12A-B-0600-0280-0305-L-D-ND
J8: Conn_01x06_MountingPin; JST_XH_S6B-XH-A-1_1x06_P2.50mm_Horizontal
J9: Conn_01x02; CON_1719740002_MOL
R1, R2, R7: 4K7; R_0603_1608Metric
R3, R4, R5, R6: 4k7; R_0603_1608Metric
TMC1, TMC2: MODULE_TMC2209_SILENTSTEPSTICK
TP1, TP2, TP3, TP4, TP5, TP6, TP7, TP8, TP9: TestPoint; TestPoint_Pad_1.5x1.5mm
U1: Pico; PICO

Connections:
5V_EN: J7.1, J8.5
12V_ENABLE: J7.11, U1.20 (GPIO15)
+3V3: J1.1, J5.1, J6.1, J7.10, J8.4, J10.1, R1.2, R2.2, R3.2, R4.2, R5.2, R6.2, TMC1.15 (VCC_IO), TMC2.15 (VCC_IO), U1.36 (3V3)
+5V: J2.1, J7.8, J8.1
+12V: J9.2, TMC1.9 (VM), TMC2.9 (VM)
/Motor1A1: J4.3, TMC1.12 (A1)
/Motor1A2: J4.4, TMC1.11 (A2)
/Motor1B1: J4.1, TMC1.14 (B1)
/Motor1B2: J4.2, TMC1.13 (B2)
/Motor2A1: J3.3, TMC2.12 (A1)
/Motor2A2: J3.4, TMC2.11 (A2)
/Motor2B1: J3.1, TMC2.14 (B1)
/Motor2B2: J3.2, TMC2.13 (B2)
BATT_SENSE_HV: J7.3, J8.3
BATT_SENSE_LV: J7.5, J8.2
DIRA: TMC1.8 (DIR), U1.10 (GPIO7)
DIRB: TMC2.8 (DIR), U1.24 (GPIO18)
ENA: TMC1.1 (EN), U1.34 (GPIO28_ADC2)
ENB: TMC2.1 (EN), U1.29 (GPIO22)
ENCODER_1A: J2.2, R1.1, TP5.1, U1.16 (GPIO12)
ENCODER_1B: J2.3, R2.1, TP6.1, U1.17 (GPIO13)
ENCODER_2A: J1.2, TP8.1, U1.6 (GPIO4)
ENCODER_2B: J1.3, TP7.1, U1.7 (GPIO5)
GND: J1.4, J2.4, J3.6, J3.7, J3.12, J5.4, J6.4, J7.6, J7.7, J7.12, J8.6, J9.1, J10.4, TMC1.6 (CLK), TMC1.10 (GND), TMC1.16 (GND), TMC2.6 (CLK), TMC2.10 (GND), TMC2.16 (GND), TP9.1, U1.3 (GND), U1.8 (GND), U1.13 (GND), U1.18 (GND), U1.23 (GND), U1.28 (GND), U1.33 (AGND), U1.38 (GND), U1.42 (GND); also elsewhere on the board
MS1A: TMC1.2 (MS1), U1.32 (GPIO27_ADC1)
MS1B: TMC1.3 (MS2), U1.31 (GPIO26_ADC0)
MS2A: TMC2.2 (MS1), U1.27 (GPIO21)
MS2B: TMC2.3 (MS2), U1.26 (GPIO20)
unnamed: R7.2, U1.21 (GPIO16)
OUT_RX: J7.2
OUT_TX: J7.4
RX1: J10.3, U1.12 (GPIO9)
SCL: J6.3, R6.1, TP4.1, U1.2 (GPIO1)
SCL_PI: J5.3, R5.1, TP2.1, U1.5 (GPIO3)
SDA: J6.2, R4.1, TP3.1, U1.1 (GPIO0)
SDA_PI: J5.2, R3.1, TP1.1, U1.4 (GPIO2)
STEPA: TMC1.7 (STP), U1.9 (GPIO6)
STEPB: TMC2.7 (STP), U1.25 (GPIO19)
TX1: J10.2, U1.11 (GPIO8)
UART_PDN: R7.1, TMC1.5 (USART), TMC2.5 (USART), U1.22 (GPIO17)

Notes on the sheet:
IMU OUTPUT

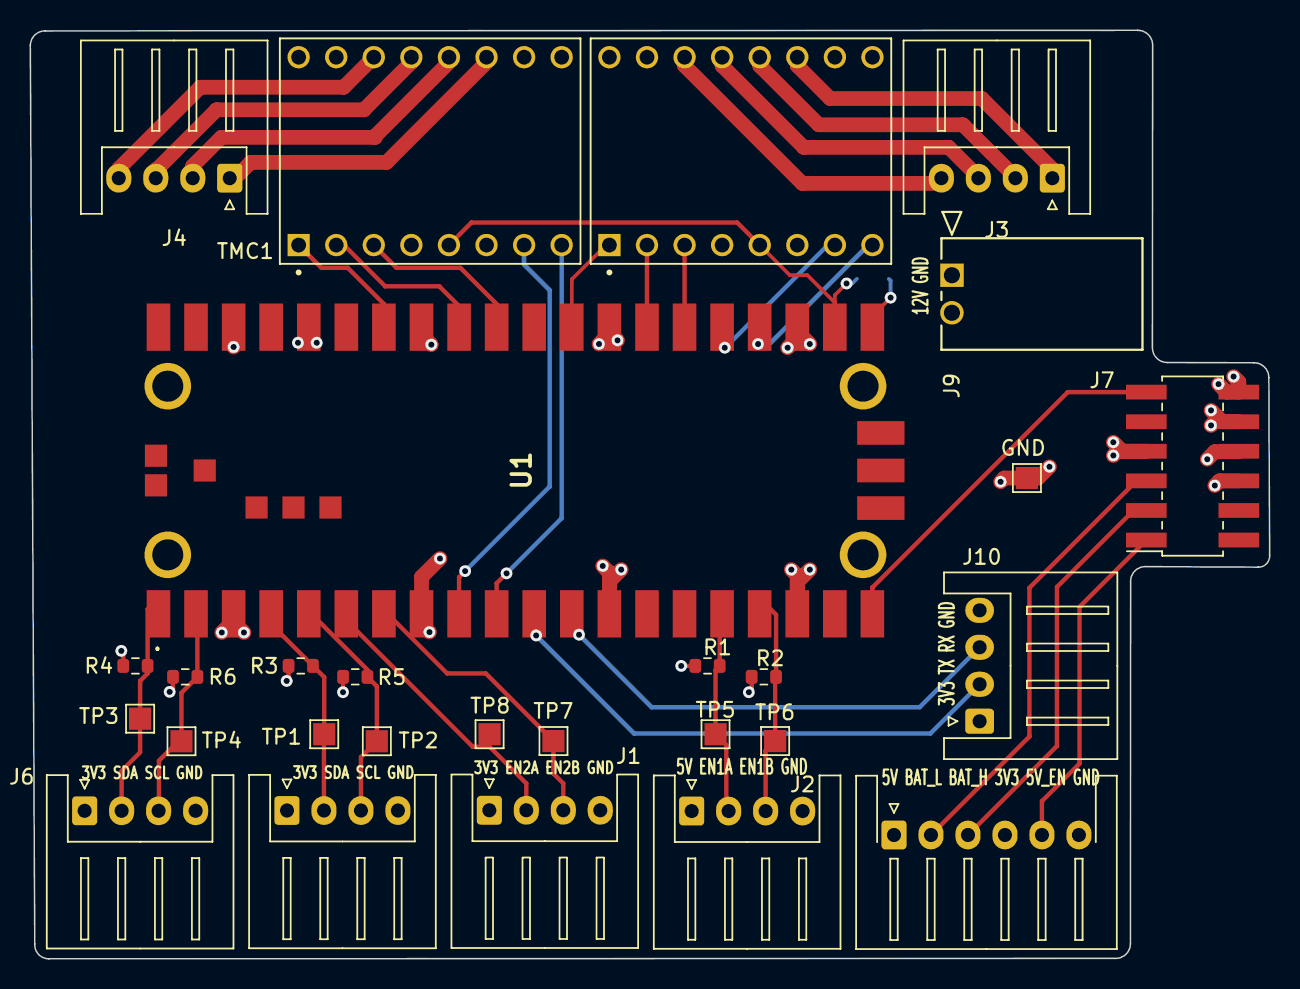
[picture p27: board PCB/FYP_P2_1/FYP_P2_1.kicad_pcb from above]

Board: 4 copper layers, 83.8 x 62.8 mm, 29 parts (1 on the bottom side), 38 nets.

Other parts of the board:
GND: TestPoint; TestPoint_Pad_1.5x1.5mm

Their connections:
GND: GND.1; also elsewhere on the board
