tuskleric/AI_Robotic_Camera/FYP_P2_1/FYP_P2_1.kicad_pcb

## KiCad design FYP_P2_1/FYP_P2_1.kicad_pcb (2024-05-13, an earlier design)

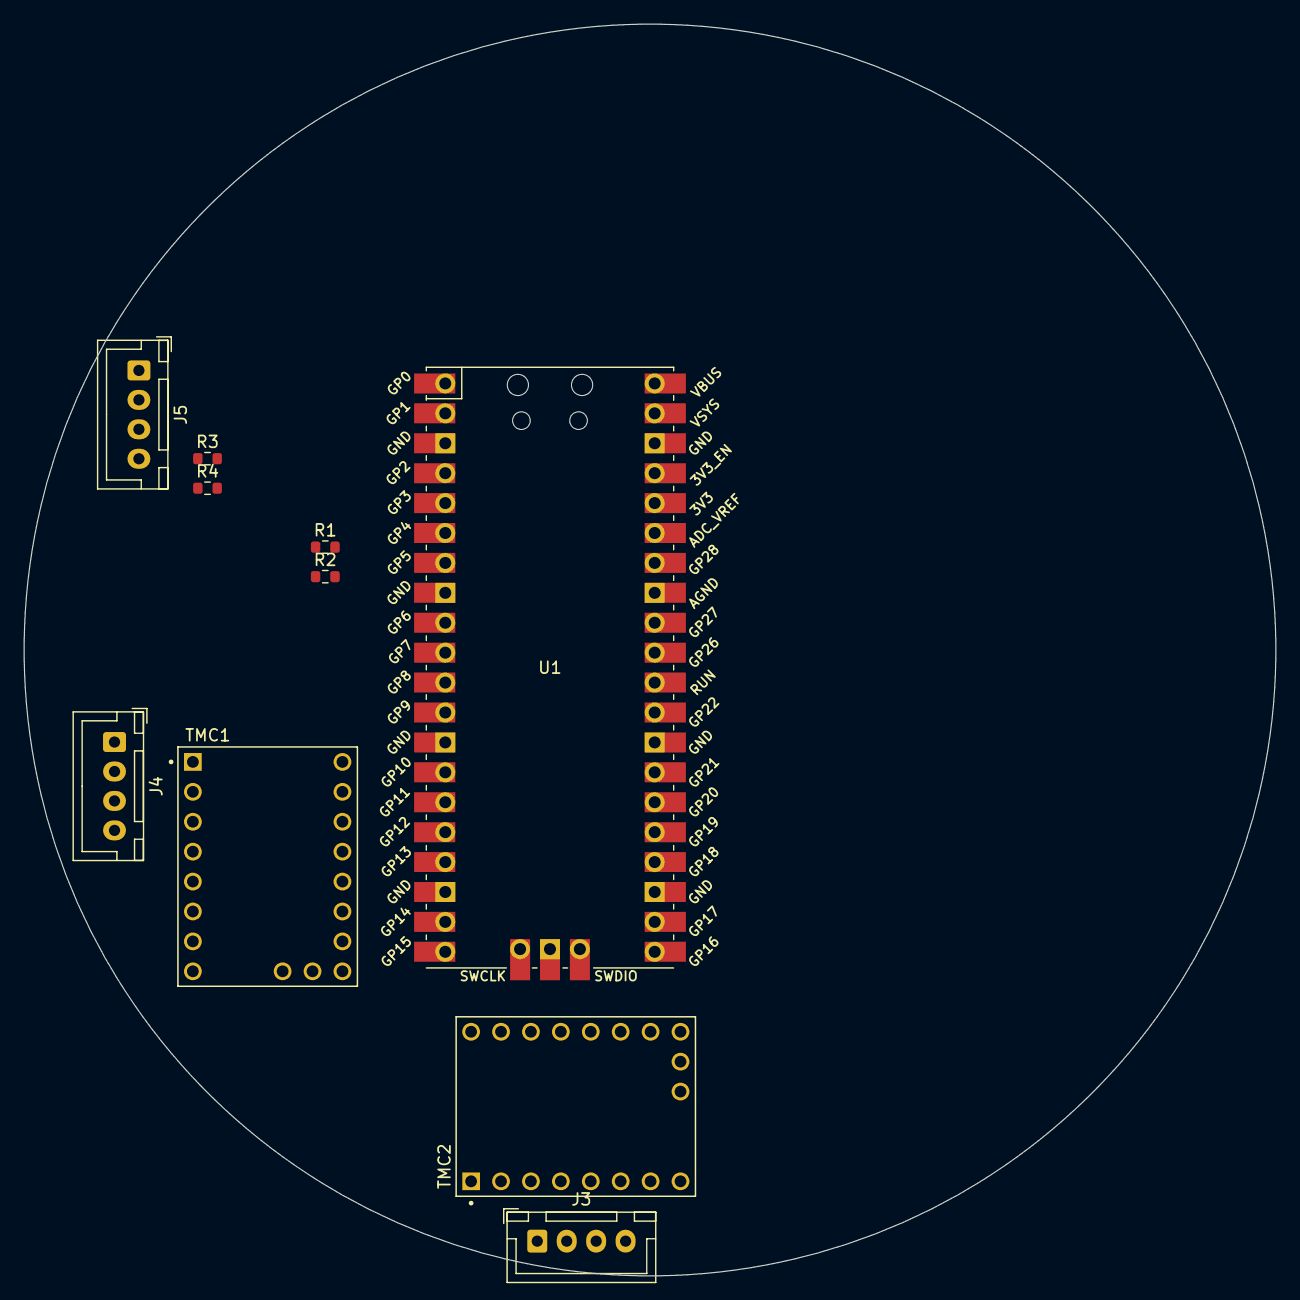
[picture p28: board FYP_P2_1/FYP_P2_1.kicad_pcb from above]

Board: 4 copper layers, 106.3 x 106.3 mm, 10 parts (0 on the bottom side), 27 nets, no tracks yet.

Parts:
J3, J4, J5: Conn_01x04; JST_XH_B4B-XH-A_1x04_P2.50mm_Vertical
R1, R2: TBD; R_0603_1608Metric
R3, R4: 4k7; R_0603_1608Metric
TMC1, TMC2: MODULE_TMC2209_SILENTSTEPSTICK
U1: Pico; RPi_Pico_SMD_TH

Connections:
+3V3: R1.2, R2.2, R3.2, R4.2
+12V: TMC1.2 (VDD), TMC2.2 (VDD)
/MotorA1A: J4.2, TMC1.4 (1A)
/MotorA1B: J4.1, TMC1.3 (1B)
/MotorA2A: J4.3, TMC1.5 (2A)
/MotorA2B: J4.4, TMC1.6 (2B)
/MotorB1A: J3.2, TMC2.4 (1A)
/MotorB1B: J3.1, TMC2.3 (1B)
/MotorB2A: J3.3, TMC2.5 (2A)
/MotorB2B: J3.4, TMC2.6 (2B)
DIRA: TMC1.8 (DIR), U1.14 (GPIO10)
DIRB: TMC2.8 (DIR), U1.24 (GPIO18)
ENCODER_1A: R1.1, U1.4 (GPIO2)
ENCODER_1B: R2.1, U1.5 (GPIO3)
GND: TMC1.1 (GND), TMC1.7 (GND), TMC2.1 (GND), TMC2.7 (GND), U1.3 (GND), U1.8 (GND), U1.13 (GND), U1.23 (GND), U1.28 (GND), U1.38 (GND), U1.42 (GND)
MS1A: TMC1.14 (MS1), U1.20 (GPIO15)
MS1B: TMC2.14 (MS1), U1.22 (GPIO17)
MS2A: TMC1.13 (MS2), U1.19 (GPIO14)
MS2B: TMC2.13 (MS2), U1.21 (GPIO16)
SCL: J5.4, R4.1, U1.2 (GPIO1)
SDA: J5.3, R3.1, U1.1 (GPIO0)
STEPA: TMC1.9 (STEP), U1.15 (GPIO11)
STEPB: TMC2.9 (STEP), U1.25 (GPIO19)
UART_RX_A: TMC1.12 (UART_RX), U1.17 (GPIO13)
UART_RX_B: TMC2.12 (UART_RX), U1.27 (GPIO21)
UART_TX_A: TMC1.11 (UART_TX), U1.16 (GPIO12)
UART_TX_B: TMC2.11 (UART_TX), U1.26 (GPIO20)
