tuskleric/AI_Robotic_Camera/FYP_P2/FYP_P2.kicad_pcb

## KiCad design FYP_P2/FYP_P2.kicad_pcb (2024-05-13)

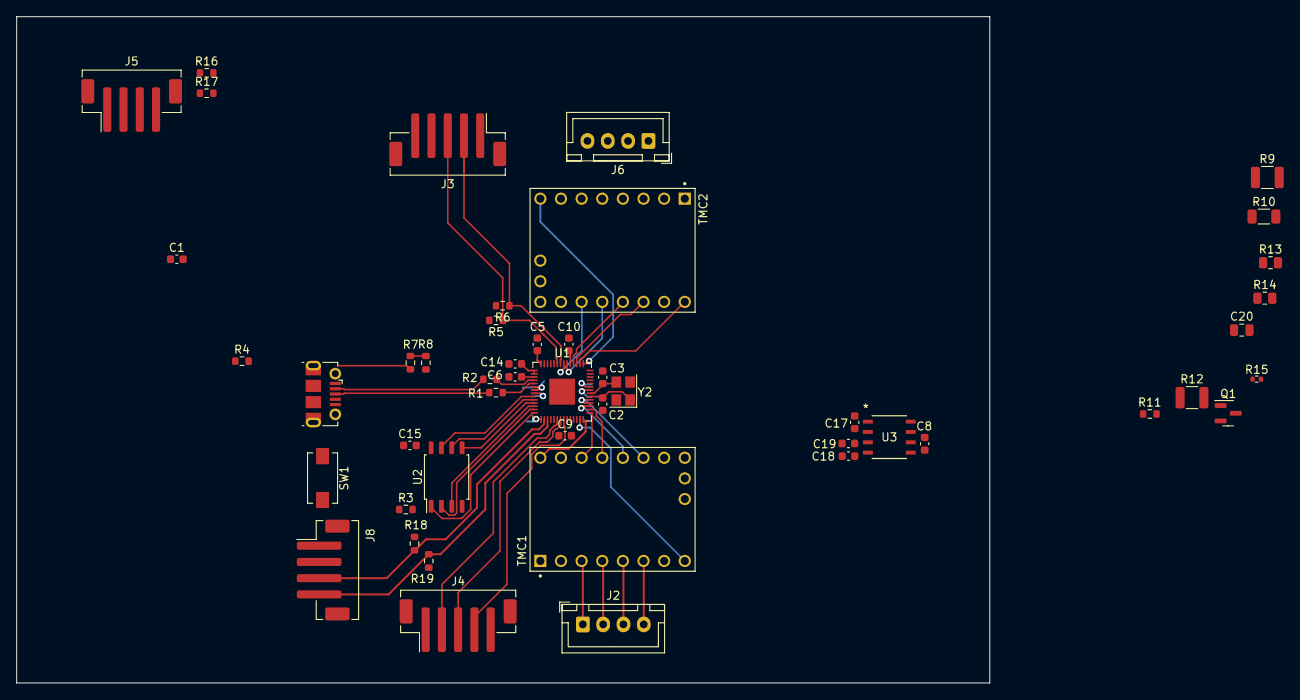
[picture p29: board FYP_P2.kicad_pcb from above]

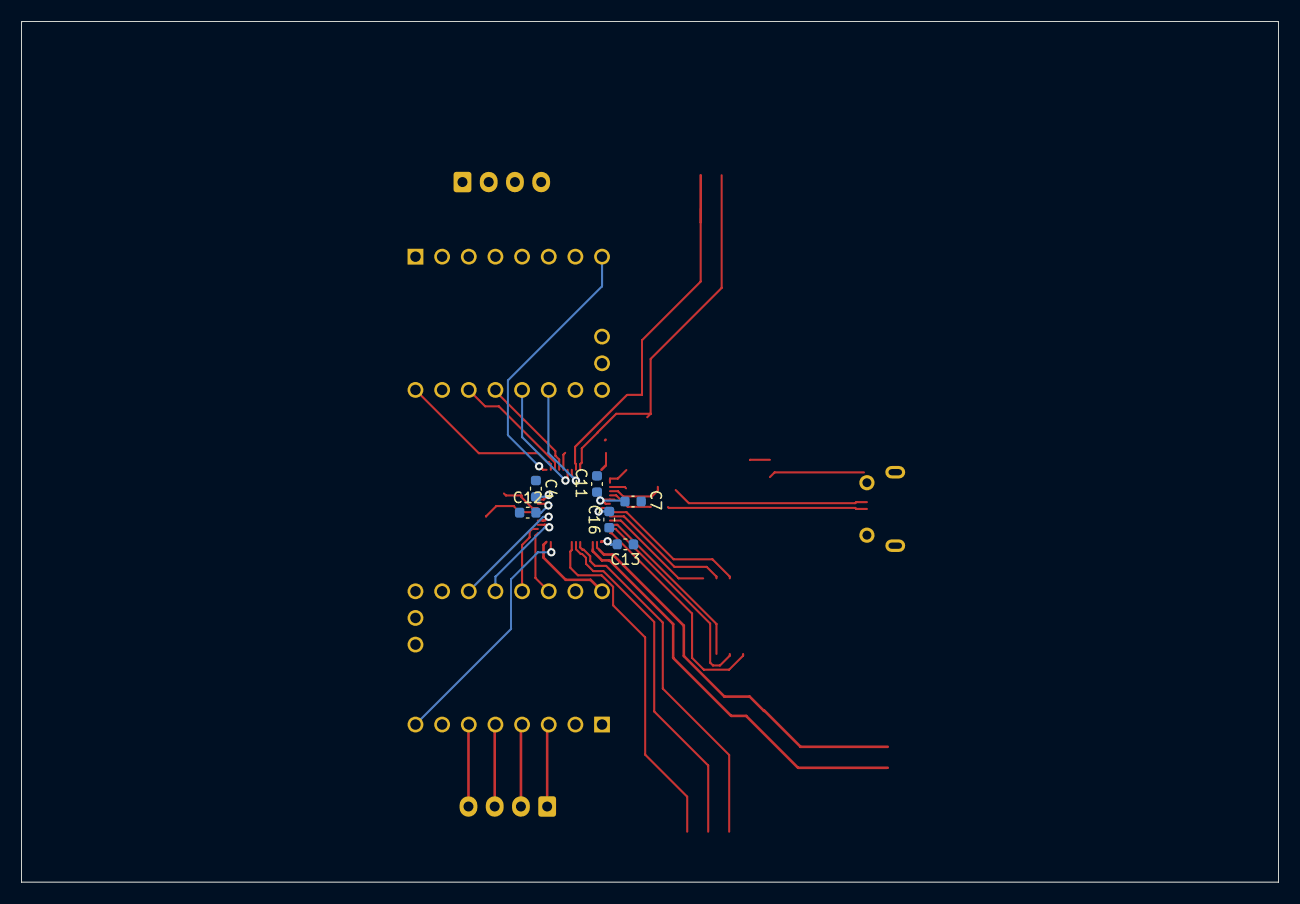
[picture p30: board FYP_P2.kicad_pcb from below]

Board: 4 copper layers, 119.8 x 82.0 mm, 54 parts (6 on the bottom side), 57 nets.

Parts:
C1: 4u7; C_0603_1608Metric
C2, C3: 15p; C_0603_1608Metric
C4, C5, C7, C9, C10, C11, C12, C13, C15, C16, C17: 100n; C_0603_1608Metric
C6, C14, C19: 1u; C_0603_1608Metric
C8: 10u; C_0603_1608Metric
C18: 22u; C_0603_1608Metric
C20: 22uF; C_0805_2012Metric
J1: USB_B_Micro; USB_Micro-B_Molex-105017-0001
J2, J6: Conn_01x04; JST_XH_B4B-XH-A_1x04_P2.50mm_Vertical
J3, J4: Conn_01x05; JST_PH_B5B-PH-SM4-TB_1x05-1MP_P2.00mm_Vertical
J5, J8: Conn_01x04; JST_PH_B4B-PH-SM4-TB_1x04-1MP_P2.00mm_Vertical
Q1: Q_PMOS_GSD; SOT-23
R1, R2: 27R; R_0603_1608Metric
R3: 1k; R_0603_1608Metric
R4: DNF; R_0603_1608Metric
R5, R6: TBD; R_0603_1608Metric
R7: 27k; R_0603_1608Metric
R8: 47k; R_0603_1608Metric
R9, R12: 2M; R_1210_3225Metric
R10: 560k; R_1206_3216Metric
R11: 33k; R_0603_1608Metric
R13: 150k; R_0805_2012Metric
R14: 22k; R_0805_2012Metric
R15: 100k; R_0402_1005Metric
R16, R17, R18, R19: 4k7; R_0603_1608Metric
SW1: SW_SPST; SW_SPST_EVQPE1
TMC1, TMC2: MODULE_TMC2209_SILENTSTEPSTICK
U1: RP2040; QFN-56-1EP_7x7mm_P0.4mm_EP3.2x3.2mm
U2: W25Q128JVS; SOIC-8_5.23x5.23mm_P1.27mm
U3: L6981N33DR; SO8L_L6981N33DR_STM-L
Y2: Crystal_GND24; Crystal_SMD_3225-4Pin_3.2x2.5mm

Connections:
+1V1: C4.2, C6.1, C16.2, U1.23 (DVDD), U1.45 (VREG_VOUT), U1.50 (DVDD)
+3V3: C5.2, C7.2, C9.2, C10.2, C11.2, C12.2, C13.2, C14.2, C15.1, C18.1, J4.1, J5.1, J8.1, R4.1, R5.2, R6.2, R16.2, R17.2, R18.2, R19.2, U1.1 (IOVDD), U1.10 (IOVDD), U1.22 (IOVDD), U1.33 (IOVDD), U1.42 (IOVDD), U1.43 (ADC_AVDD), U1.44 (VREG_IN), U1.48 (USB_VDD), U1.49 (IOVDD), U2.8 (VCC), U3.4 (FB/VOUT)
+12V: C8.2, C20.1, J3.1, Q1.2 (S), TMC1.2 (VDD), TMC2.2 (VDD), U3.5 (EN/CLKIN), U3.7 (VIN)
/MotorA1A: J2.2, TMC1.4 (1A)
/MotorA1B: J2.1, TMC1.3 (1B)
/MotorA2A: J2.3, TMC1.5 (2A)
/MotorA2B: J2.4, TMC1.6 (2B)
/MotorB1A: J6.2, TMC2.4 (1A)
/MotorB1B: J6.1, TMC2.3 (1B)
/MotorB2A: J6.3, TMC2.5 (2A)
/MotorB2B: J6.4, TMC2.6 (2B)
/PWR/+Batt: R9.1, R12.1
/QSPI_SCLK: U1.52 (QSPI_SCLK), U2.6 (CLK)
/QSPI_SD0: U1.53 (QSPI_SD0), U2.5 (DI(IO0))
/QSPI_SD1: U1.55 (QSPI_SD1), U2.2 (DO(IO1))
/QSPI_SD2: U1.54 (QSPI_SD2), U2.3 (IO2)
/QSPI_SD3: U1.51 (QSPI_SD3), U2.7 (IO3)
/QSPI_SS: R3.1, R4.2, U1.56 (QSPI_SS), U2.1 (~CS)
/USB_DETECT: R7.1, R8.2, U1.12 (GPIO9)
/USB_N: J1.2 (D-), R2.1
/USB_P: J1.3 (D+), R1.1
/~USB_BOOT: R3.2, SW1.2 (B)
BATT_SENSE_HV: R12.2, R13.1, U1.38 (GPIO26_ADC0)
BATT_SENSE_LV: R9.2, R10.1, U1.39 (GPIO27_ADC1)
DIRA: TMC1.8 (DIR), U1.13 (GPIO10)
DIRB: TMC2.8 (DIR), U1.29 (GPIO18)
ENCODER_1A: J3.2, R6.1, U1.36 (GPIO24)
ENCODER_1B: J3.3, R5.1, U1.37 (GPIO25)
ENCODER_2A: J4.2, U1.6 (GPIO4)
ENCODER_2B: J4.3, U1.7 (GPIO5)
ENCODER_2C: J4.4, U1.8 (GPIO6)
GND: C1.2, C2.1, C3.1, C4.1, C5.1, C6.2, C7.1, C8.1, C9.1, C10.1, C11.1, C12.1, C13.1, C14.1, C15.2, C16.1, C18.2, C19.2, C20.2, J1.5 (GND), J1.6 (Shield), J3.5, J4.5, J5.2, J8.2, R8.1, R11.2, R14.2, R15.2, SW1.1 (A), TMC1.1 (GND), TMC1.7 (GND), TMC2.1 (GND), TMC2.7 (GND), U2.4 (GND), U3.6 (AGND), U3.8 (PGND), Y2.2, Y2.4
MS1A: TMC1.14 (MS1), U1.18 (GPIO15)
MS1B: TMC2.14 (MS1), U1.35 (GPIO23)
MS2A: TMC1.13 (MS2), U1.17 (GPIO14)
MS2B: TMC2.13 (MS2), U1.34 (GPIO22)
unnamed: Q1.1 (G), R15.1
unnamed: R10.2, R11.1
unnamed: R13.2, R14.1
unnamed: R2.2, U1.46 (USB_DM)
unnamed: R1.2, U1.47 (USB_DP)
unnamed: C2.2, U1.20 (XIN), Y2.1
unnamed: C3.2, U1.21 (XOUT), Y2.3
unnamed: C17.2, U3.2 (BOOT)
unnamed: C17.1, U3.1 (SW)
unnamed: C19.1, U3.3 (VCC)
SCL: J8.4, R19.1, U1.3 (GPIO1)
SCL_PI: J5.4, R17.1, U1.5 (GPIO3)
SDA: J8.3, R18.1, U1.2 (GPIO0)
SDA_PI: J5.3, R16.1, U1.4 (GPIO2)
STEPA: TMC1.9 (STEP), U1.14 (GPIO11)
STEPB: TMC2.9 (STEP), U1.30 (GPIO19)
UART_RX_A: TMC1.12 (UART_RX), U1.16 (GPIO13)
UART_RX_B: TMC2.12 (UART_RX), U1.32 (GPIO21)
UART_TX_A: TMC1.11 (UART_TX), U1.15 (GPIO12)
UART_TX_B: TMC2.11 (UART_TX), U1.31 (GPIO20)
VBUS: C1.1, J1.1 (VBUS), R7.2
