tuskleric/AI_Robotic_Camera/(commit log)

2024-05-13 added PCB
    [06JQ-ST.STEP, B4B-PH-SM4-TB.STEP, B5B-PH-SM4-TB.STEP, BOM.xlsx, FYP_P2.kicad_pcb, FYP_P2.kicad_sch, FYP_P2_1.kicad_pcb, FYP_P2_1.kicad_sch]
2024-10-09 PCB files added
    [0532610471.step, 1719740002.step, 532610671.step, BOM.csv, BOM_f.csv, BTT TMC2209-V1.2.STEP, EDI2CAP.CFG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]
